KoreanJD/orchard-rover/docs/robot-arm-spec.md

# 로봇팔 사양 (6축) — 검증본

작성: 2026-10-26 · 검증: `arm_check.py`, `arm_workspace.py`, `transport_check.py` · CAD: `shoulder_joint.py`, `wrist_joint.py`, `arm_assembly.py`, `base_joint.py` · 케이블: [robot-arm-cable-routing.md](robot-arm-cable-routing.md)

## 개요
- **6축** (J1 요 Z / J2 어깨 Y / J3 팔꿈치 Y / J4 전완 롤 X / J5 손목 피치 Y / J6 툴 롤 X) — 협동로봇 표준 6R
- 리치 1,050 mm (J2 축 → ISO 플랜지), 가반 3 kg, 팁 속도 0.5 m/s (J2 ≤ 25~30°/s)
- 팔 자중 ≈ 15 kg, 36 V DC, CAN, IP54
- 툴: 집게 / 전동 가위(톱 대체, 모델 선정 보류 — 1순위 마끼다 DUP361 36V 33mm) / 예초기, ISO 9409-1-50-4-M6 + 수동 퀵체인저
- 베이스 마운트: 구동체 상단 레일 X=+300 (차동 바 스윙 영역 X=−150±120 회피), J2 축 Z=958
- 관절 한계: J1 ±180 / J2 −20~90 / **J3 ±120 (케이블 드럼 제약)** / J4 ±180 / J5 ±110 / J6 ±180

## 작업 영역 (툴 팁 = 플랜지 + 150)
| 작업 높이 | 전방 도달 (차체 중심 기준) |
|---|---|
| 최대 높이 2.16 m | X≈0.3 (차체 바로 위) |
| 2.0 m | 0.95 m |
| 1.5 m | 1.38 m |
| 1.0 m | 1.50 m (최대), 측방 1.2 m |
| 0.5 m | 1.42 m |
| 0.1 m (밑동 제초) | ~0.9 m |

**[결정] 작업 범위 = 수관 하단~중단 0~2.0 m. 2 m 이상 상단 전정은 사람 작업으로 분리.**
대안: ① J2 축 +300 상향 → 2.46 m, 전도 마진 1.9→1.6 / ② 링크 +100 연장 → 2.36 m, J2 토크 +20%

## 운반 자세 (`transport_check.py`, 간섭 최소 거리 기준 ≥ 15 mm)
| 자세 | 관절각 (J1/J2/J3/J5) | 최소 거리 | 외형 X | 높이 | 비고 |
|---|---|---|---|---|---|
| **T3 뒤로 접기 (기본)** | 180 / 60 / −120 / 60 | 92.3 (전완↔상완) | −289 ~ +382 (차체 안) | 1.47 m | 차동 바 231, 배터리 존 125 |
| T6 뒤로 저자세 | 180 / 40 / −120 / 80 | 15.7 (플랜지↔배터리 존) | 차체 안 | 1.44 m | 배터리 배치 확정 후 |
| T4 앞으로 접기 | 0 / 45 / −120 / 75 | 72.1 (상완↔가스 스프링 클레비스) | +891 전방 돌출 | 1.39 m | |
| 뒤로 J2 ≤ 25° | 180 / 25~0 | **0 (충돌)** | — | — | 차동 포스트·프레임 |

## 링크
베이스→어깨 200 / 상완 500 (HFS6-3030 ×2 사다리, Z 60 간격 — 케이블 채널 겸용, 양단 링 하우징 회피로 X 85~415) / 전완 422 (J4 하우징 80 + Al 튜브 Ø50×2t) / 손목 128
J2·J3 모두 출력 플랜지가 상완 측판 +Y 면에 체결, 모터는 +Y. J2 고정부(링·모터)는 J1 브라켓, J3 고정부는 전완판(J3 어댑터 겸용 10t)에 체결 → J4 하우징은 YZ 연결 브라켓(J4 모터 통과 창)에 체결, J3 축 +120 (J4 모터가 J3 링 하우징 뒤로 빠지지 않도록). 손목 체인은 팔 중심선(Y=0)

## 관절 액추에이터 (스테퍼 실사용 = 홀딩 50%, η 0.8, 동적 계수 1.5)
| 관절 | 축 | 정적 토크 | 필요 | 액추에이터 | 출력 | 속도 |
|---|---|---|---|---|---|---|
| J1 요 | Z | — | 15 | NEMA23 2.0 + 1:15 유성, 크로스롤러 80/120/16 | 24 | 45°/s |
| J2 어깨 | Y | 79.7 | 65 (가스 스프링 FGSS22120C 필수, 전 각도 최대) | NEMA23 4.0 (57×112) + 1:50 사이클로이드 + 브레이크 | 80 | 30°/s |
| J3 팔꿈치 | Y | 30.1 | 45 | NEMA23 3.0 (57×76) + 1:45 사이클로이드 + 브레이크 | 54 | 30°/s |
| J4 전완 롤 | X | 6.5 | 9.7 | NEMA17 0.8 + 1:36 유성 | 11.5 | 45°/s |
| J5 손목 피치 | Y | 5.5 | 8.2 | NEMA17 0.8 + 1:36 유성 | 11.5 | 45°/s |
| J6 툴 롤 | X | 0.9 | 1.5 | NEMA17 0.45 + 1:20 유성 | 3.6 | 60°/s |

주의: 사이클로이드/하모닉은 역구동됨 → J2·J3 전자 브레이크 필수

## 사이클로이드 감속기 (자체 제작)
| | J2 (50:1) | J3 (45:1) |
|---|---|---|
| 핀 | 51 × Ø5 다월핀, R=70 | 46 × Ø5, R=63 |
| 편심 e | 0.6 | 0.6 |
| 디스크 | OD 136, Al 8t ×2 (180°) | OD 122, 8t ×2 |
| 출력 핀 | Ø8 ×8 @PCD 80 | Ø8 ×8 @PCD 72 |
| 하우징 OD | 165 | 151 |
- 설계 규칙: `e < R/N` 만으로 부족 — **핀 간격(2πR/N − 2Rr) ≥ Rr** 이 지배적
- 프로파일: 기준 에피트로코이드를 Rr 만큼 법선 오프셋(수치), DXF 출력

## 손목
J4 하우징 Ø76×80 → 전완 튜브 Ø50×2t → J5 요크(뒷판 + 12t 양측, 길이 85) → 손목 블록 50×60×60 (J6, 카메라 마운트) → ISO 9409-1-50 플랜지 Ø63×8
- J4 하우징 보어: 모터 여유 Ø58 | 감속기 파일럿 Ø42 | 축 여유 Ø46 | 롤 베어링 6810 시트 Ø65. 출력 허브가 베어링 내륜을 관통, 감속기 출력축 Ø8 보어
- J5: +Y 감속기 출력면 ↔ 블록 Ø12 축, −Y 치크 6001 ↔ 블록 Ø12 축. 요크 뒷판은 J5 ±110° 에서 블록·카메라 회전 반경(≈56) 밖
- 손목 블록: J6 모터 포켓(후면 개방), 앞벽 5t 에 모터 전면·J6 감속기 체결

## 사이클로이드 조인트 적층 (J2·J3 공통)
어댑터 10t(J2 = J1 브라켓, J3 = 전완판) | 링 하우징(핀 구간 20 + 출력 베어링 외륜 시트 W−0.5) | 디스크 8t ×2 (캠 베어링 6002 ×2) | 출력 플랜지 (저널 = 베어링 내경, 캡 하면 릴리프 0.5 로 내륜만 접촉)

## 가동 범위 간섭 (`motion_check.py`, 부품 단위 간섭 > 1 mm³)
J1 ±180 / J2 −20~90 / J3 ±120 / J4 ±180 / J5 ±110 / J6 ±180 단일 관절 스윕(10°, 171 자세) 충돌 없음.
조합 210 자세 중 28 충돌 — **모두 팔 ↔ 차체** (팔 자체 간섭 없음), 경로 계획에서 회피할 운용 제약:
- J2 = −20 에서 |J1| ≥ 135 (뒤쪽): 전완판·J4 하우징 ↔ 차동 포스트·바, J3 = −120 이면 J3 모터 ↔ 로커 플레이트
- J1 = ±90 (측면) 에서 J2 ≤ 0, J3 = −120: J4 하우징·전완 튜브 ↔ 프레임 상단 레일
- J2 = 0, J3 = −120 (전완을 아래로 접음): J5 모터(J4 = −90) 또는 ISO 플랜지(J5 ≈ ±90~110) ↔ 프레임
세부 목록은 `output/arm/motion_check.txt`

## 가스 스프링 밸런서 (J2)
**[결정 2026-10-31] MISUMI FGSS22120C** (가스스프링 장착방향자유형: 스트로크 120, 아이 간 320~440, 반력 392 N @최대−10, 실린더 Ø22). 압축형, 상완 측판 바깥 평면 (팔 좌표 Y −76).
- 베이스 앵커: 팔 좌표 (−35, −150) = J1 터릿 상면 위 50 클레비스 (J1 축에서 X −35)
- 상완 앵커: J2 축에서 r 280, 팔 방향보다 +10° (측판 X 276 / Z 49) — J2 측판을 X 210 → 285 로 연장 (J3 측판 X 290 과 5 간격), M8 스터드
- J2 −20~90° 길이 327~434 (양끝 여유 7 / 6), 수평 보상 48.6 N·m (61 %)
- J2 액추에이터 부담 (전개+툴 79.7 cosφ / 접힘·툴 없음 23.2 cosφ 중 큰 쪽 ×1.5): 최대 **65.3 N·m @31°** (용량 80 의 82 %). 스프링 없으면 120 N·m
- 가스 스프링 반력은 거의 일정이라 cosφ 형 중력을 정확히 따라가지 못함 → 부담은 각도 전 구간에서 계산 (`gas_spring_balance`). 반력 증가율 +30 % (압축 끝) 는 카탈로그 미기재라 일반값 가정
- 선정 과정: FGSS 17 종 × 앵커 위치 탐색. 이전 기하 (r 100, h 180, 350 N) 는 길이 174~279 (신축비 1.6) 가 필요해 맞는 표준품이 없었음. 스프링 없이 NEMA34 (160 N·m) 로 가는 안은 감속기 재검토 부담으로 보류

## J1 베이스
베이스 플레이트 12t (200×820) → 크로스롤러 → 터릿 12t → 수직 브라켓 10t (폭 180, 상단 R90, 수직 거셋 12t ×2: 깊이 60 × 높이 240) → J2. 브라켓이 J2 사이클로이드 어댑터를 겸함 (+Y 면 NEMA23, −Y 면 링 하우징). 구동부는 플레이트 아래 매달림

## 부품 강도 (`arm_check.plate_strength`, 수평 완전 전개·툴 3 kg·동적 ×1.5, 항복 기준)
| 부품 | 응력 | 안전율 | 비고 |
|---|---|---|---|
| J1 브라켓 10t + 거셋 | 4.0 MPa | 70 | J2 토크 80 N·m(액추에이터 최대) + 축 하중(스프링 반력 포함). 면외 휨에 의한 팔 끝 변위 0.04 mm (팔 자체 처짐 0.62 mm 의 6%) |
| 전완판 10t (J4 모터 창 단면) | 3.2 MPa | 85 | |
| J4 하우징 베어링 시트 (벽 5.5) | 1.5 MPa | 186 | 굽힘 + J4 출력 토크 비틀림 |
| J5 축 Ø12 (SUS304) | 1.3 MPa | 158 | |
- 거셋이 수평 삼각으로 잘못 모델링돼 면외 강성이 없었음 → 수직으로 수정. 수정 전 10t 판 단독이면 팔 끝 변위 0.90 mm
- 팔 처짐 계산의 전완 단면을 실제 형상(Al 튜브 Ø50×2t, I 8.7×10⁴)으로 수정 (이전엔 HFS 3030 단면) → 팔 끝 처짐 1.14 → 0.62 mm

## 가공 도면 (`plate_dxf.py` → `output/dxf/`, 두께 중앙 단면, 구멍 위치 = 조립 좌표)
상완 측판 J2·J3, 전완판, 연결 브라켓, J1 브라켓·거셋, J1 베이스 플레이트·터릿. 목록·두께·구멍 수: `output/dxf/plates.txt`

## 전도 (구동체 60 kg + 팔 15 + 툴 3, 트랙 반폭 529)
평지 측면 완전 전개 마진 ≈ 4.5 / 횡경사 15° ≈ 2.0 → 경사 10° 이상 측면 리치 70% 제한

## 대표 궤적 (`arm_workspace.py`)
운반(T3) → 상단 전정 (0.90, 1.95) 툴 45° 상향 → 중단 전정 (1.25, 1.30) → 밑동 제초 (0.90, 0.10) 툴 80° 하향 → 운반

## MoveIt2 기술 패키지 (`urdf_export.py` → `output/urdf/orchard_rover_description/`)
- ROS 2 ament 패키지: `urdf/orchard_rover.urdf`, `srdf/orchard_rover.srdf`, `meshes/{visual,collision}/*.stl` (mm STL × 0.001)
- 링크: base_link(구동체 + J1 고정부) → j1_link → upper_arm → forearm_root → forearm_tube → wrist → flange → tool0
- 관절 축·부호는 CAD 자세 함수(`place`)와 동일: J1 +Z, J2·J3·J5 −Y (양수 = 들어 올림), J4·J6 +X. 원점 J2 축 = (0.300, 0, 0.958) m
- 한계 = 가동 범위 표, effort·velocity = 액추에이터 표. SRDF: arm 그룹(base_link→tool0), home·transport(T3) 자세, 인접 링크 충돌 제외
- 충돌 메시는 coarse (공차 3 mm). 관성은 CAD 체적 × Al 밀도 근사 (모터 실밀도 아님) — 동역학 제어용으로는 실측 보정 필요
- 가스 스프링은 2체 부품이라 미포함. 조합 자세의 팔↔차체 충돌 구간(가동 범위 절)은 base_link 충돌 메시로 MoveIt 이 회피
- 검증: URDF 순기구학으로 옮긴 부품 질량중심 = CAD 자세 (임의 6축 자세 3종, 0.01 mm 이내)

## 제어
SBC + ROS2·MoveIt2 → CAN 마스터 MCU 100 Hz → CAN 폐루프 스테퍼 드라이버 ×6 (모터 일체). 손목 카메라 비전 서보, 툴 접촉 센서, 전류 한계 충돌 감지

## 비용 ≈ 255만원 (팔) + 툴 3종·체인저·카메라 ≈ 90만

## 점검 이력 (2026-10-26)
- 스테퍼 홀딩 토크 오류 교정 → J2/J3/J4 상향 / 역구동 오류 교정 → 브레이크 / 경사 전도 CG 항 추가
- 사이클로이드 핀 겹침 교정 (R 52→70, 핀 Ø8→Ø5) / 5축→6축 / J3 1:40→1:45
- 작업 범위 0~2.0 m 확정 / 케이블 드럼 도입, J3 ±140→±120 / 운반 자세 T3 확정

## 점검 이력 (2026-10-29, Fusion 간섭 검사 후속)
- J3 체결을 J2 와 같은 방향으로 (플랜지→상완 측판, 링·모터→전완판). 기존 배치는 링 Ø151 이 측판 홀 Ø74 를 지나야 해 성립 불가
- 상완 레일 X 60~440 → 85~415 (J2·J3 링 하우징 간섭)
- J1 브라켓 12t(모터 측) → 10t 어댑터 자리 (J2 모터와 겹침)
- 가스 스프링 앵커 축 위 → 축 아래 (계산식과 CAD 부호 불일치), 앵커 포스트 삭제
- (2026-10-31) 가스 스프링을 MISUMI 표준품 FGSS22120C 로 확정, 앵커 재배치, J2 측판 X 285 까지 연장
- 출력 플랜지 볼트 PCD 를 관절별로 (J3 90→76, 캡 Ø96 밖으로 빠지던 문제), 볼트 홀은 캡 두께만
- 링 하우징이 어댑터와 1 mm 떠 있고 출력 베어링 외륜 지지가 없던 문제 → 하우징을 어댑터 면부터 베어링 시트까지 연장, 캠 베어링 추가
- 손목 하우징·블록 솔리드 → 보어·포켓 (J4 하우징 Ø64→76: 베어링 Ø65 가 들어가지 않았음), J5 축 추가
- 가동 범위 검토 신설 → J5 ±110° 에서 블록·카메라가 요크 뒷판과 충돌 → 요크 60→85 (J5 축 위치 불변, 튜브 25 단축)
- 부품 강도 검토 신설 → J1 브라켓 거셋 수평 모델링 오류 수정 (수직 60×240), 판재 DXF 추가
