KoreanJD/orchard-rover/docs/rocker-bogie-suspension.md

# Rocker-Bogie 서스펜션 설계 기록

생성: 2026-10-23 · 도구: CadQuery 2.8 / ezdxf · 코드: `orchard_rover/rocker_bogie_params.py`, `orchard_rover/rocker_bogie_cad.py`
개정: 2026-10-23 — 10인치 휠·전방 허브모터 구동, 피벗 브라켓 SHF16 표준품 치환, BOM 원가 추가
개정: 2026-10-29 — 팔 장착 하중 케이스, 로커 축 Ø20/SHF20/6004ZZ, 전방 외측 포크, 암 폭 70
개정: 2026-10-30 — MISUMI 웹 교차검증: SHF20 T20 반영, 세트 칼라 PSCS20-12, 시리즈 5 홈 위치·M5 체결, 하단 레일 Z 310
개정: 2026-10-31 — 아이들러 축 SFJ20 + SHF20 홀더 + PSCS20-12, 판 일체 베어링 보스 → MISUMI BGRBB 베어링 홀더 볼트 체결, 보기 축 바깥 끝 PSCS12-10, 차동 핀 STWN12 스냅링

## 구조 (NASA MER/MSL 방식)
- 차체 연결점 3개: 좌/우 로커 피벗(측면 레일, 하중 지지) + 차동 바 피벗(상부 중앙, Z축 회전)
- 로커: 전방 휠(F, 구동) + 보기 피벗(B) + 상방 암(U, 차동 링크 연결)
- 보기: 중간 휠(M) + 후방 휠(R) — V자 플레이트, 아이들러
- 차동: 바(878mm, Z축 회전) 양단 ↔ 로커 상방 암을 X 방향 링크 로드(150mm, 로드엔드)로 연결
- 차체 피치 = (좌 로커각 + 우 로커각)/2 (수평 "유지"가 아님)

## 좌표 (X 전방, Y 좌측, Z 상방, 지면 Z=0, 단위 mm)
| 점 | X | Y(좌) | Z |
|---|---|---|---|
| P 로커 피벗 | 0 | 439 | 300 |
| F 전방 휠(구동) | 450 | 529 | 125 |
| M 중간 휠 | 0 | 529 | 125 |
| R 후방 휠 | -450 | 529 | 125 |
| B 보기 피벗 | -225 | 459 | 200 |
| U 상방 암 끝 | 0 | 439 | 750 |
| D 차동 바 피벗 | -150 | 0 | 750 |

휠베이스 900, 트랙 1058 (외측 포크 포함 전폭 1182), 로커 전방 암 483 / 후방 암 246 / 상방 암 450, 보기 암 237×2
프레임: 하단 레일 중심 Z=310(지상고 290), 상단 레일 Z=700. HFS5-4040 은 한 면에 홈 2줄(면 중심 ±10)이라 하단 레일 아래 홈(Z 300)이 로커 피벗 높이

## 프레임 (MISUMI HFS5-4040, `frame_members`)
- 좌우 레일 1000 ×4 (하단 Z 310 / 상단 Z 700) 이 관통, 앞뒤 가로대 720 ×4·차동 크로스멤버 720 ×1·J1 크로스멤버 720 ×2 는 레일 안쪽 면에 맞대기, 기둥 350 ×4 는 하단 레일 위 / 상단 레일 아래 맞대기 → 15 본, 10.44 m, 13.4 kg (카탈로그 1.28 kg/m)
- 체결: 맞대기 끝단 M5 탭 (코너 구멍 Ø4.2) + 관통 부재 렌치 홀 → M5 캡 스크류 22 곳. 레일 상·측면이 베이스 플레이트·피벗 홀더·차동 포스트 체결면이라 외부 브라켓은 쓰지 않음
- CAD 단면: 외곽·홈 위치(면 중심 ±10)·홈 개구 6·코너 구멍은 카탈로그, T홈 내부·중앙 공동은 근사
- 절단 목록: `output/robot/frame_cut_list.txt`

## 설계 근거
- 로커 피벗 X = (x_F + 2·x_B)/3 → 3륜 등하중 (각 98 N @ 60 kg). 피벗을 뒤로 옮기면 전방 휠이 가벼워져 등반 유리
- 보기 피벗 = 중간·후방 휠 중점, 휠 축보다 75 높음
- 차동 링크는 X 방향 배치 필수 — Y 방향(바 반경 방향)이면 바 끝단 원호 운동으로 구속 과잉
- 차동 1:1 연동 오차 ±15° 범위에서 <0.5°
- 휠 Ø150(UWRF 최대)은 1000mm 프레임·과수원 지면에 과소 → 10인치(Ø250) 공압으로 변경
- 전방 구동 선택: 로커 직결 휠이라 하중이 항상 1/3로 안정. 20cm급 장애물 등반이 필요하면 후방 허브모터 추가(4WD)

## 부품
- 로커/보기/차동 바: Al 6061-T6 12t **단일 두께** 플레이트, 암 폭 70 (워터젯 + 탭, DXF 포함). 베어링 보스를 판과 한 몸으로 깎지 않고
  MISUMI **BGRBB 베어링 홀더 세트**(라운드 플랜지, 베어링 2개·스냅링 조립품, S45C)를 판 구멍(몸통 D, H7)에 끼우고 플랜지를 볼트로 체결:
  | 위치 | 홀더 | 플랜지 Ø×두께 / 몸통 Ø×길이 | 볼트 | 방향 |
  |---|---|---|---|---|
  | 로커 피벗 P | BGRBB6004DD-40 (6004 ×2) | Ø77×11 / Ø50×29 | M6 ×4 @P.C.D.64 (판 탭) | 플랜지 판 안쪽 면, 몸통 바깥으로 17 돌출 |
  | 보기 피벗 B | BGRBB6001DD-25 (6001 ×2) | Ø52×8 / Ø34×17 | M4 ×4 @P.C.D.42 (판 탭) | 플랜지 판 바깥면, 몸통 안쪽으로 5 돌출 |
  | 차동 바 | BGRBB6001DD-25 | 〃 | 〃 (바 중앙 Ø58 패드) | 플랜지 바 윗면, 몸통 아래로 5 돌출 |
  축 위 정지측은 내륜 스페이서로 축방향 위치 결정: SHF20 | 스페이서 Ø28 5.95 | 홀더(회전) | 스페이서 Ø28 4.95 | PSCS20-12,
  로커 판 | 스페이서 Ø16 5.85 | 보기 홀더 | 스페이서 Ø16 3.85 | PSCS12-10, 포스트 기둥 | 스페이서 Ø16 4.85 | 차동 홀더 | 스페이서 Ø16 3.85 | STWN12. 과수원 분진 → 접촉 고무 씰 DD
  (로커 홀더 플랜지 11 만큼 로커가 바깥으로, 보기 홀더 몸통 돌출 때문에 로커-보기 간격 6→8 → 트랙 1032→1058)
- 로커 피벗: SHF20 플랜지형 샤프트 홀더(주조 AC7A, L60·T20(축방향 전체)·t8·A34, 2홀 Ø7 @48 → M5 + 와셔 + HNTT5-5, 하단 레일 아래 홈) + SFJ20 직선축(SUJ2) + BGRBB6004DD-40(로커 판) + PSCS20-12 세트 칼라(외경 40)
- 보기 피벗: SFJ12 길이 53(로커 판 압입) + BGRBB6001DD-25(보기 판) + PSCS12-10 세트 칼라(외경 30, 홀더 플랜지와 간극 1) / 차동 피벗: 포스트 Ø12 핀 + BGRBB6001DD-25(차동 바) + STWN12 축용 C형 스냅링(핀 홈 Ø11.5×1.15, 홀더 윗면 위 1)
- 휠: 전방 10" BLDC 허브모터 36V 350W ×2 (M18 2S 36V 직결), 중간·후방 10" 3.00-4 공압 아이들러 ×4
- 아이들러 축: SFJ20 외팔 축 — 보기 판 구멍 Ø20.05 + 판 바깥면 **SHF20 홀더**(Y축 90° 돌려 볼트 줄 세로, M6 ×2 → 판 12t 탭)로 클램프.
  휠 허브 베어링 내경 20 ×2 (모델 6004ZZ, 시판 3.00-4 휠은 6204 계열 내경 20 이 흔함 → 구매 시 내경 20 선택).
  축 적층: 판 | 홀더 T20 | 스페이서 4 (Ø20/Ø28, 내륜만 받침) | 휠 80 | 와셔 2 | PSCS20-12 칼라 — 축 길이 132.
  SHF20·PSCS20-12 는 로커 피벗과 같은 부품 (아이들러 ×4 에 홀더 4, 칼라 4 추가)
- 전방 허브모터 고정축 M12: 로커 플레이트 + **외측 포크**(12t, 축 → 로커 피벗 방향 185 짧은 암, Ø20 스탠드오프·M10) 양쪽 지지 (`front_fork.dxf`)
- 링크: Ø8 로드 + 로드엔드(PHS8) ×2, 길이 조정식

**[결정 2026-10-29] 로커 축 = Ø20 + 6004ZZ + SHF20/PSCS20-12.** 처음엔 단붙이 Ø16/17/16 을 택했으나, 팔 장착 하중 케이스에서 축 SF 2.49 로 부족해 대안으로 전환:
| 안 | 장점 | 단점 |
|---|---|---|
| 단붙이 Ø16/17/16 | SHF16·6003ZZ 유지 | 축 가공 1품, 팔 하중 SF 2.49 |
| **Ø20 + 6004ZZ + SHF20/PSCS20-12 (채택)** | 전부 표준 직선축, 축 SF 4.86 | 베어링 폭 10→12, 보기-휠 간격 10→16 (축 끝·칼라와 중간 휠 Y 분리) |
| 내경 16 특주 베어링 | 축 그대로 | 조달·단가 불리 |
- MISUMI 교차검증 (2026-10-30): SHF20 의 T20 은 플랜지 포함 축방향 전체 길이 (모델이 28 로 8 길었음 → 돌출 20). `SCS20` 은 미스미에서 섀클(타사) → 세트 칼라는 `PSCS20-12` (외경 40). 시리즈 5 홈 T너트는 M3~M5 뿐이라 SHF20 Ø7 홀도 M5 로 체결

## 하중 케이스 (`load_cases`, `wheel_loads`)
원래 설계는 구동체 60 kg 만이었으나 실제로는 팔 15 kg + 툴 3 kg 이 J1 (X=+300) 에 실린다.
차체 피치 모멘트는 차동 바가 두 로커의 공통 회전을 막으므로 링크를 통해 로커로 들어가 전방 휠 하중을 바꾼다.
| 케이스 | 총 질량 | CG (X, Y) | 전방 휠 (좌/우) | 최저 SF |
|---|---|---|---|---|
| 구동체만 (원설계) | 60 | (0, 0) | 98 / 98 N | 휠 5.10 |
| 운반 (접힘) | 78 | (69, 0) | 167 / 167 | 휠 3.00 |
| 전방 전개 | 78 | (179, 0) | 229 / 229 | 휠 2.18 |
| 대각 45° 전개 | 78 | (147, 78) | 234 / 188 | 휠 2.14 |
| 측방 전개 | 78 | (69, 110) | 199 / 134 | 휠 2.51 |
| 후방 전개 | 78 | (−40, 0) | 105 / 105 | 휠 3.60 |
값은 `output/design_summary.txt` 생성값.

## 안전율 (전 케이스·좌우 최저, 동하중 ×3)
로커 베어링 8.5 / 보기 베어링 6.6 / 휠 2.1 / 로커 면내 굽힘 8.0 / 면외 2.7 / 로커 축@SHF20 4.0 / 전방 허브모터 축 2.6 / 아이들러 축 8.7 / 아이들러 홀더 볼트 22.9
- 기준 2.5. 휠은 정격 1500 N 에 동하중 ×3 을 건 보수적 값이라 2.0 으로 별도 판정 (정적 SF 6.4)
- 이전(구동체만, 외팔보 Ø16 액슬) 기준으로는 전방 액슬 3.8 이었으나, 팔 하중 대각 전개에서 1.6 → 외측 포크로 양쪽 지지
- 아이들러 축: 홀더 보스 끝 단면 외팔보 (휠 중앙 하중, 팔 44), SUS304 σy 205 로 보수적. 홀더 볼트: 판 바깥면 모멘트 ÷ 볼트 간격 48 → M6 8.8 인장
- 보기-휠 간격 16→24 로 전방 허브모터 축 지지 간격이 늘어 2.72→2.62 (기준 2.5 이상)
- 전방 축은 허브모터 M12 고정축(플랫 10 단면, 8.8 급 σy 640 가정) 기준. 축 강종·플랫 치수는 모터 사양으로 확인

## BOM 원가 (추정 ±30%, 서스펜션+전방 구동계만)
| 항목 | 금액(원) |
|---|---|
| 로커·보기 플레이트 워터젯 ×4 | 230,000 |
| SHF20 ×6 + PSCS20-12 ×6 (로커 피벗 2 + 아이들러 4) | 81,000 |
| BGRBB6004DD-40 ×2 (로커) | 87,840 |
| BGRBB6001DD-25 ×3 (보기 2 + 차동 1, DD 는 ZZ ×1.1 추정) | 75,150 |
| PSCS12-10 ×2 (보기 축 바깥 끝) + STWN12 ×1 (차동 핀) | 14,763 |
| 전방 외측 포크 워터젯 ×2 + 스탠드오프 | 40,000 |
| 차동 바·포스트 | 50,000 |
| 허브모터 ×2 + 컨트롤러 ×2 | 300,000 |
| 아이들러 휠 ×4 | 100,000 |
| 축·스페이서·로드엔드·크로스멤버 (피벗 베어링은 홀더 세트에 포함) | 108,000 |
| 체결류 | 30,000 |
| **합계** | **≈ 1,117,000** |

## 미결 사항
- 프레임 상단 중앙 X=−283 ~ −17 (차동 바 피벗 −150 ± 133, ±15° 스윙 + 바 폭) 은 차동 바 스윙 영역 — 배터리 배치 시 비워둘 것. 배터리 팩 규격(M18 2S 형식·치수) 확정 후 배치 모델링
- 허브모터 M12 축 드롭아웃 (플랫 폭·축 길이·토크 와셔) — 모터 사양 확정 후 로커 플레이트·외측 포크 홀을 슬롯으로 교체 (현재 Ø12.05 원형)
- 상세 프레임 브라켓, 블레이드 데크와의 간섭 — 데크 사양 확정 후 검토
- 해결 (2026-10-31): 차동 바 핀 — 홀더 윗면 위 "멈춤링 자리 4" 만 있어 차동 바가 핀에서 위로 빠질 수 있었음 → 위 베어링 내륜 스페이서 Ø16 3.85 + 핀 홈에 STWN12 스냅링 (핀 끝은 홀더 윗면 위 4 그대로 — PSCS12-10 칼라는 핀이 9 길어져 팔을 뒤로 접은 J1 ±180·J3 −120 자세에서 J4 하우징과 닿아 기각)
- 해결 (2026-10-31): 보기 축 바깥 끝 — 로커 판 압입 축에 보기 그룹(홀더·베어링)을 바깥쪽으로 잡아 주는 부품 없이 "멈춤링 자리 10" 만 있었음 → 바깥 베어링 내륜 스페이서 Ø16 3.85 + PSCS12-10 칼라 (축 50→53, 축 끝이 중간 휠 내측면보다 3 안쪽)
- 해결 (2026-10-31): 판 일체 베어링 보스 — 문서는 "12t 워터젯" 인데 모델은 로커 P 보스 30 / 보기 B 보스 20 / 차동 바 허브 20 두께라 2D 가공으로 불가 → MISUMI BGRBB 홀더 볼트 체결, 판은 단일 두께 (로커 축 SF 4.9→4.0, 트랙 1032→1058)
- 해결 (2026-10-31): 아이들러 휠 — 사양 메모의 6003ZZ(내경 17)와 축 Ø16 불일치, 축이 판 구멍에 꽂히기만 하고 고정·빠짐 방지 없음 → SFJ20 + SHF20 홀더 + PSCS20-12 칼라, 보기-휠 간격 16→24 (트랙 1016→1032)
- 해결 (2026-10-29): SHF16 단일 클램프 캔틸레버 → 축 Ø20/SHF20 로 SF 4.9 (2점 지지는 축 굽힘을 줄이지 못해 채택 안 함)
