KoreanJD/orchard-rover/docs/img/cable_routing.png

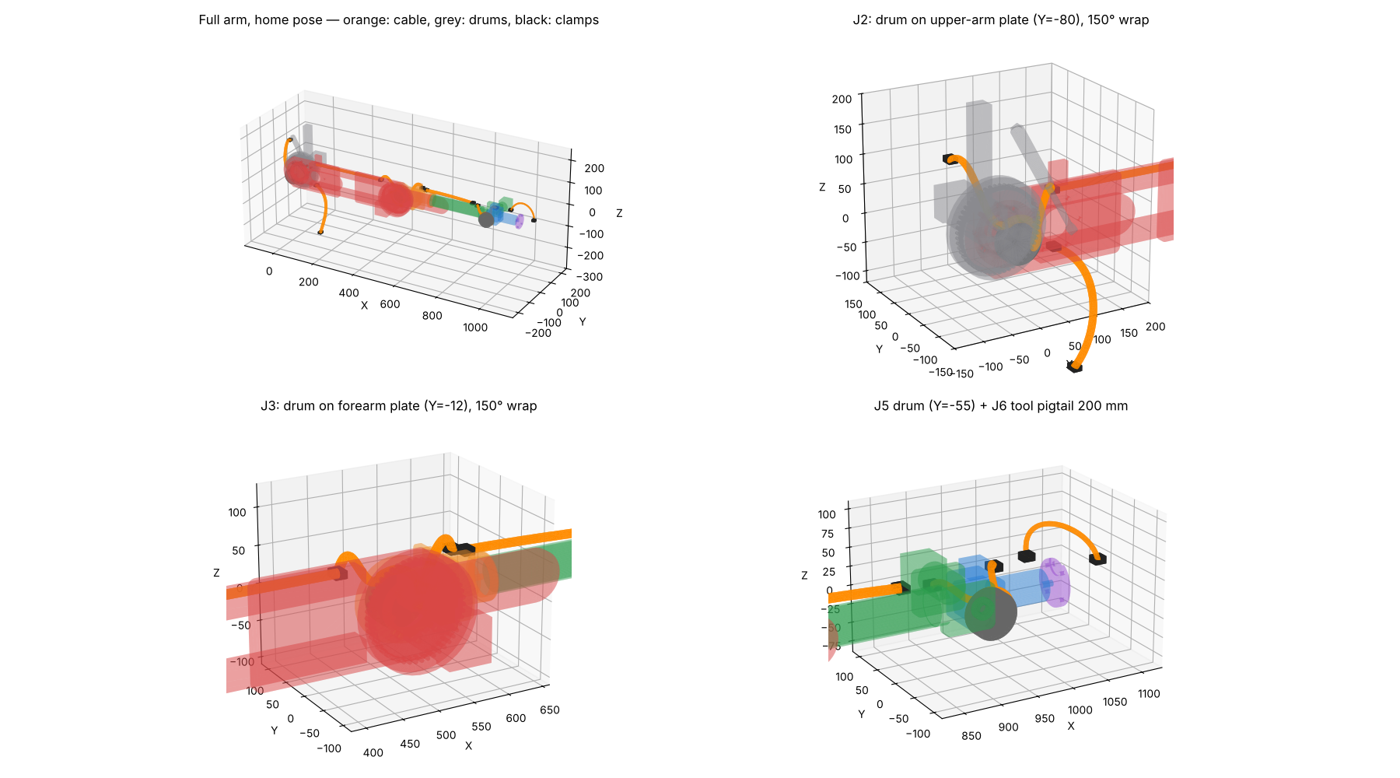
docs/img/cable_routing.png
