KoreanJD/orchard-rover/docs/img/pose_bent.png

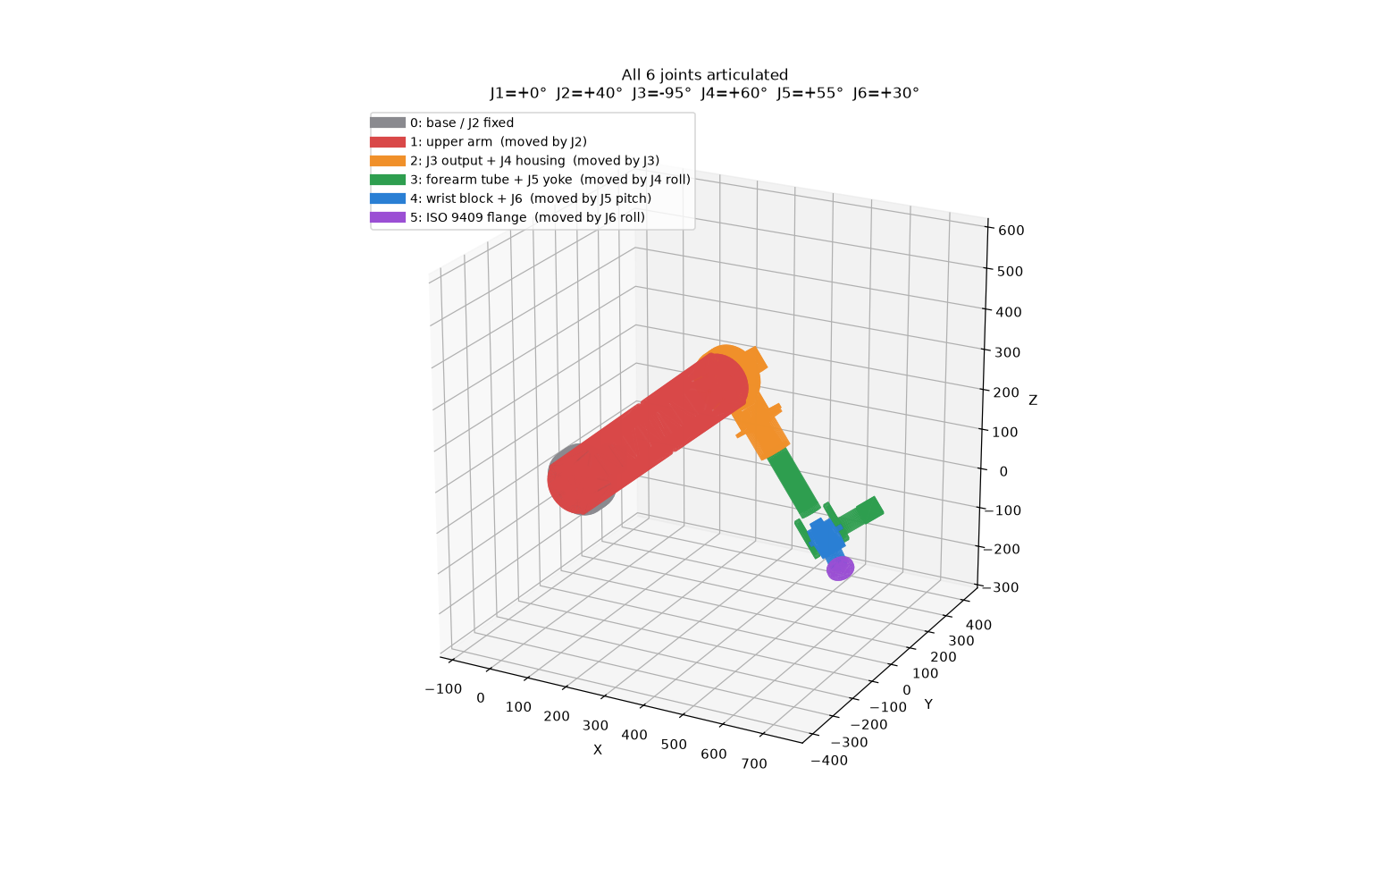
docs/img/pose_bent.png
