KoreanJD/orchard-rover/docs/img/shoulder_cycloid.png

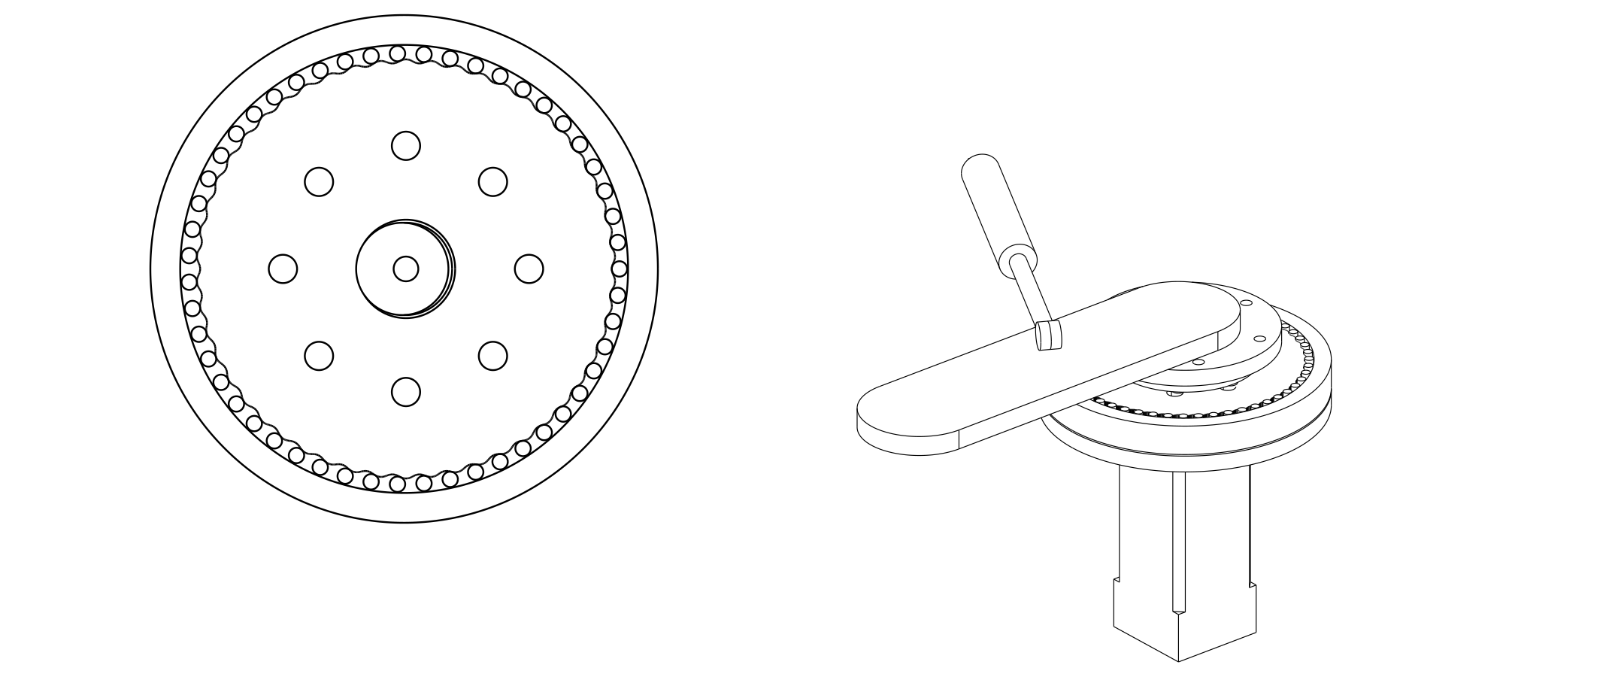
docs/img/shoulder_cycloid.png
