KoreanJD/orchard-rover/docs/img/transport_poses.png

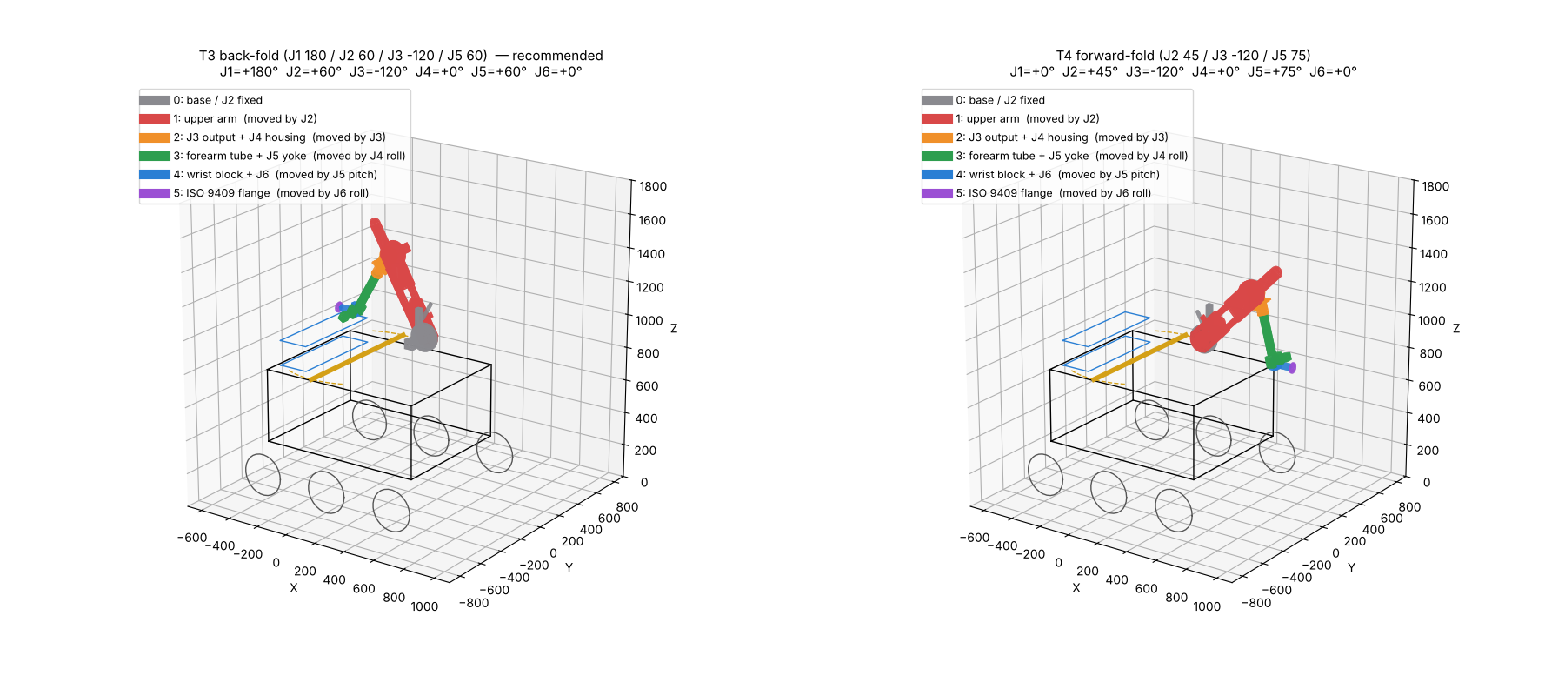
docs/img/transport_poses.png
