KoreanJD/orchard-rover/docs/img/workspace_xz.png

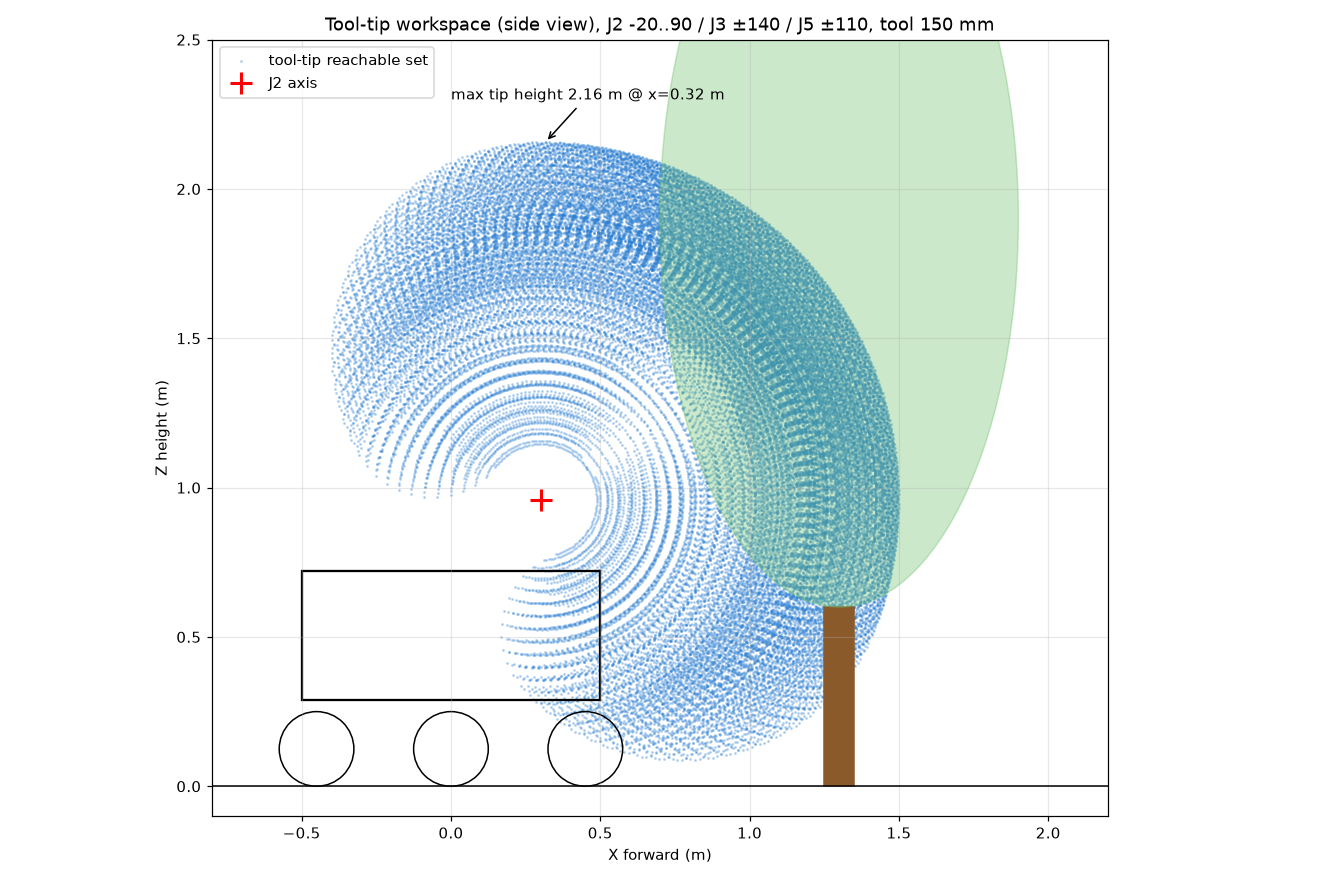
docs/img/workspace_xz.png
