KoreanJD/orchard-rover/output/arm/arm_iso.png

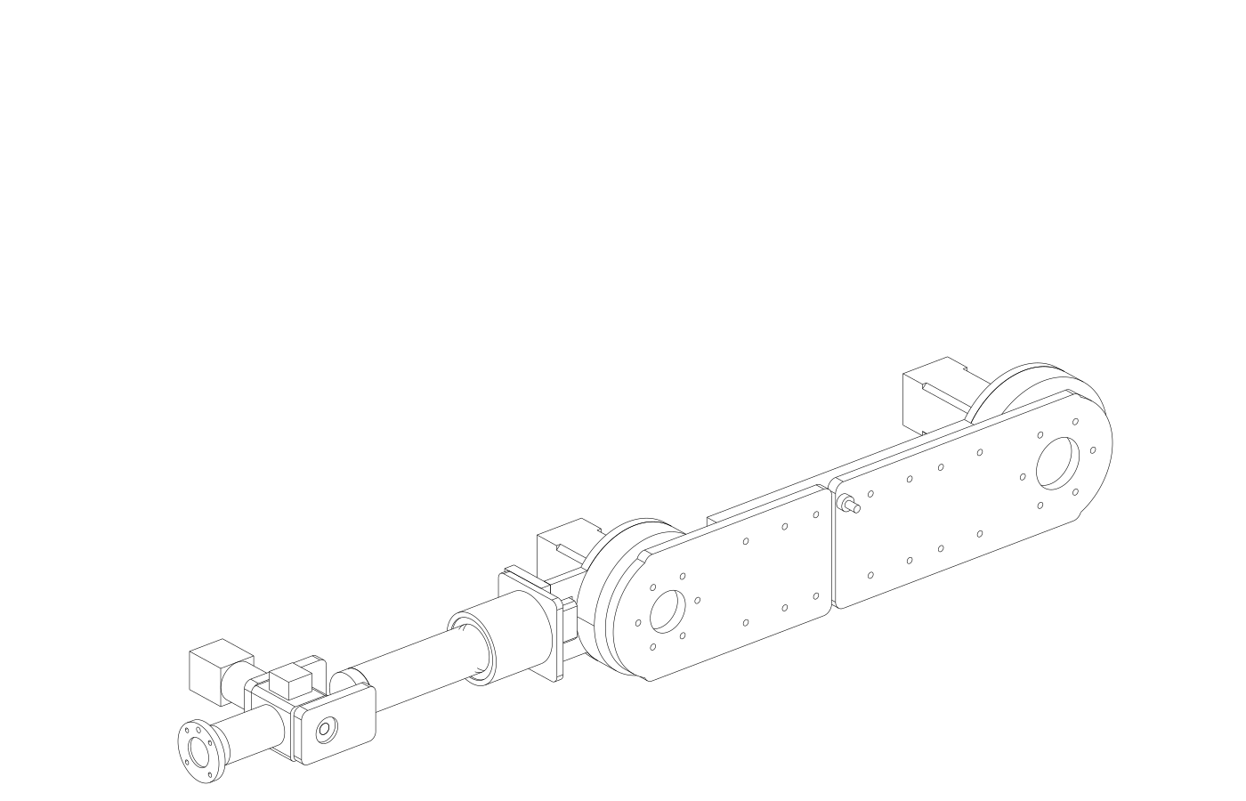
output/arm/arm_iso.png
