KoreanJD/orchard-rover/output/arm/arm_side.png

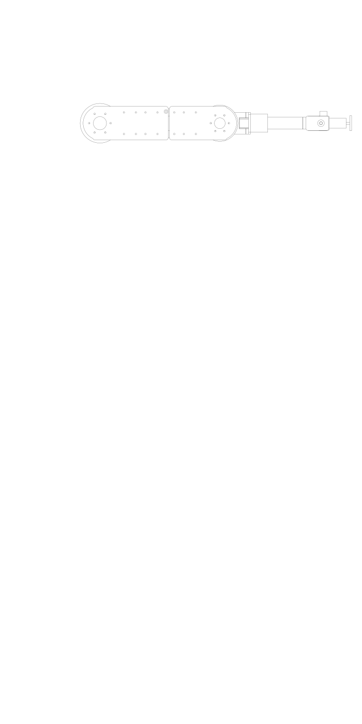
output/arm/arm_side.png
