KoreanJD/orchard-rover/output/arm/pose_fold.png

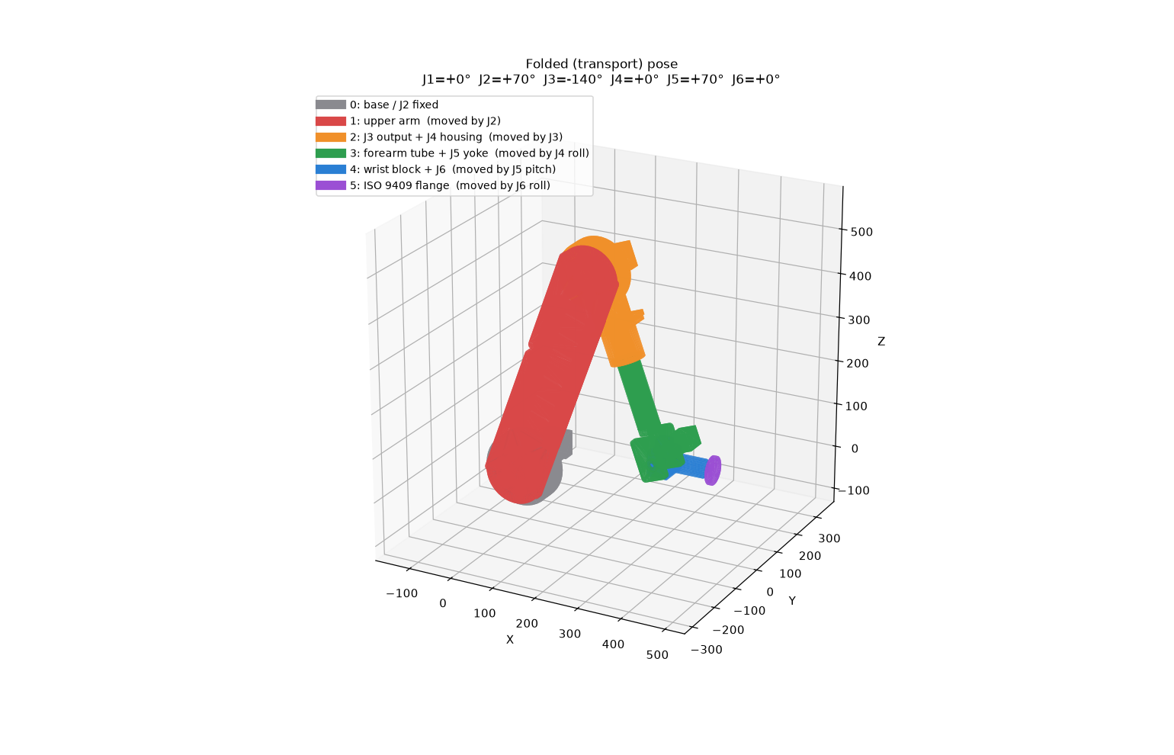
output/arm/pose_fold.png
