KoreanJD/orchard-rover/output/arm/wrist_iso.png

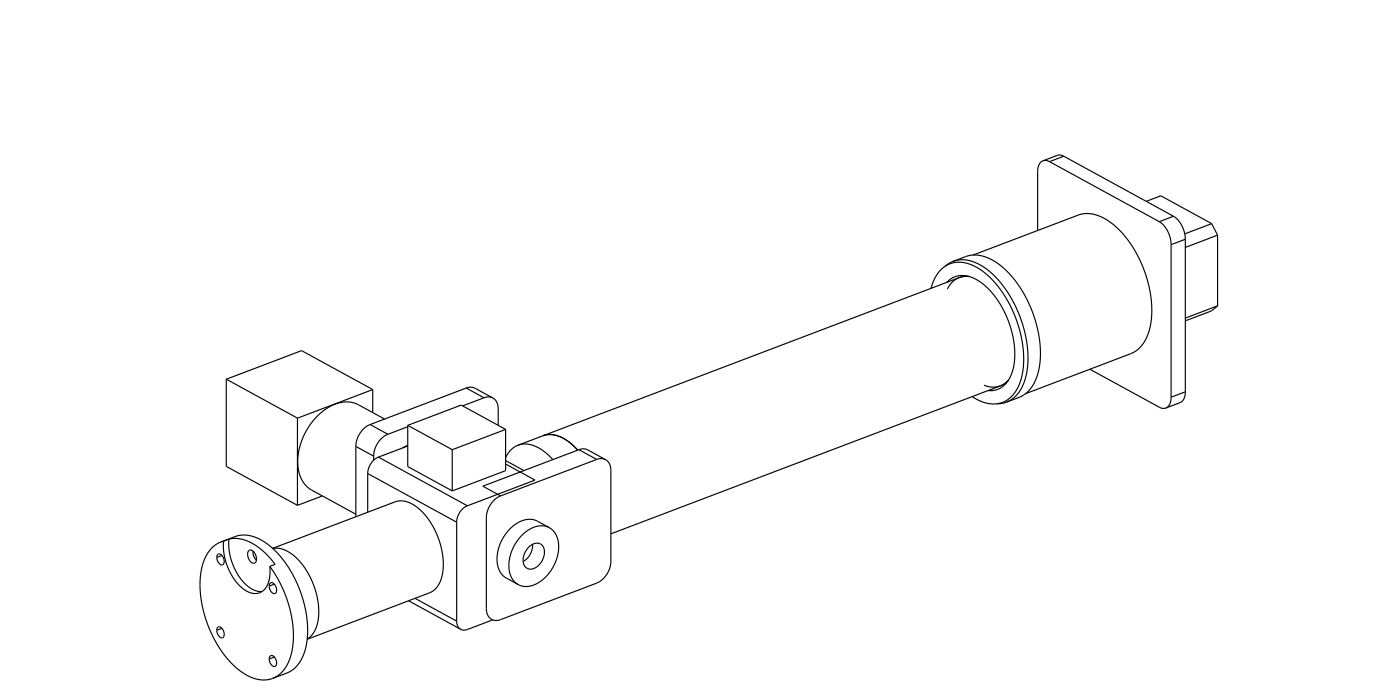
output/arm/wrist_iso.png
