KoreanJD/orchard-rover/output/elbow/shoulder_iso.png

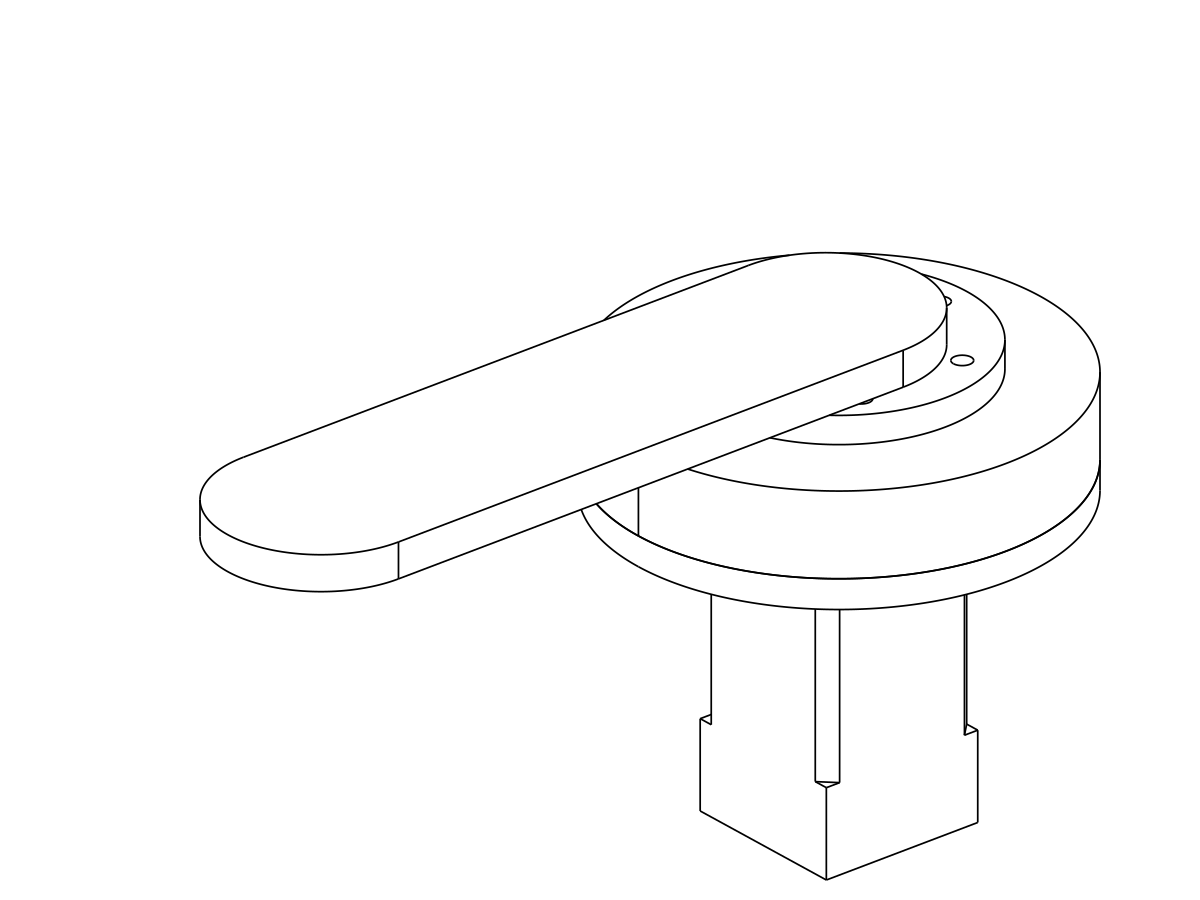
output/elbow/shoulder_iso.png
