KoreanJD/orchard-rover/output/elbow/shoulder_top.png

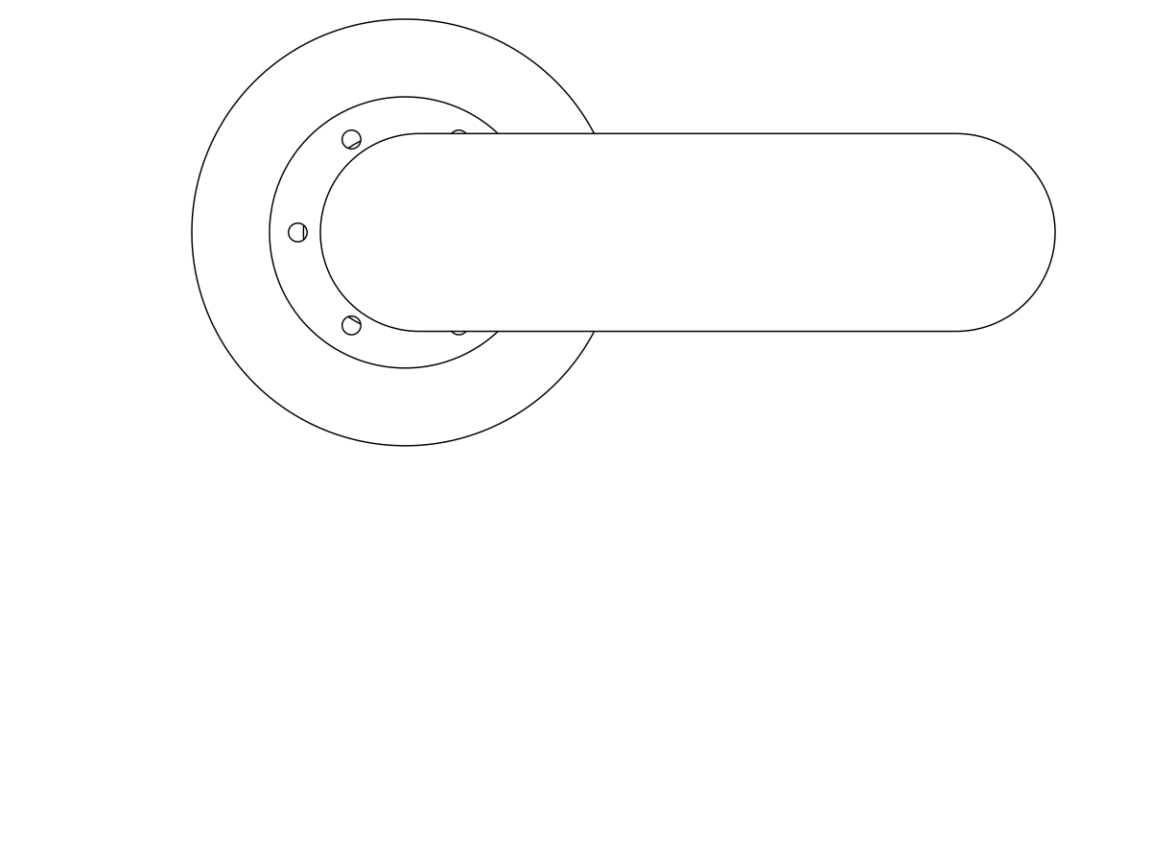
output/elbow/shoulder_top.png
