KoreanJD/orchard-rover/output/robot/robot_front.png

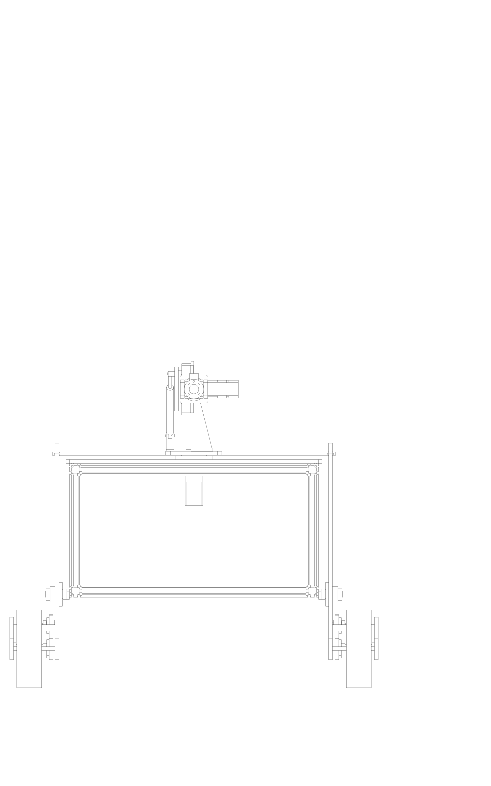
output/robot/robot_front.png
