KoreanJD/orchard-rover/output/robot/robot_side.png

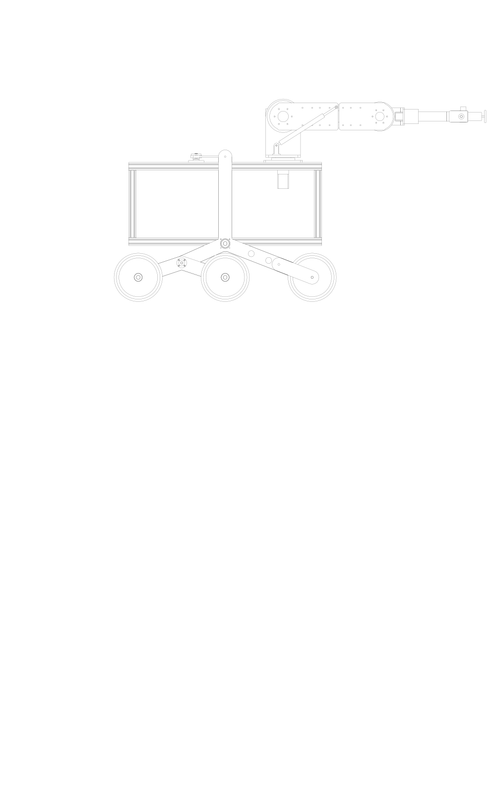
output/robot/robot_side.png
