KoreanJD/orchard-rover/output/rocker_bogie_front.png

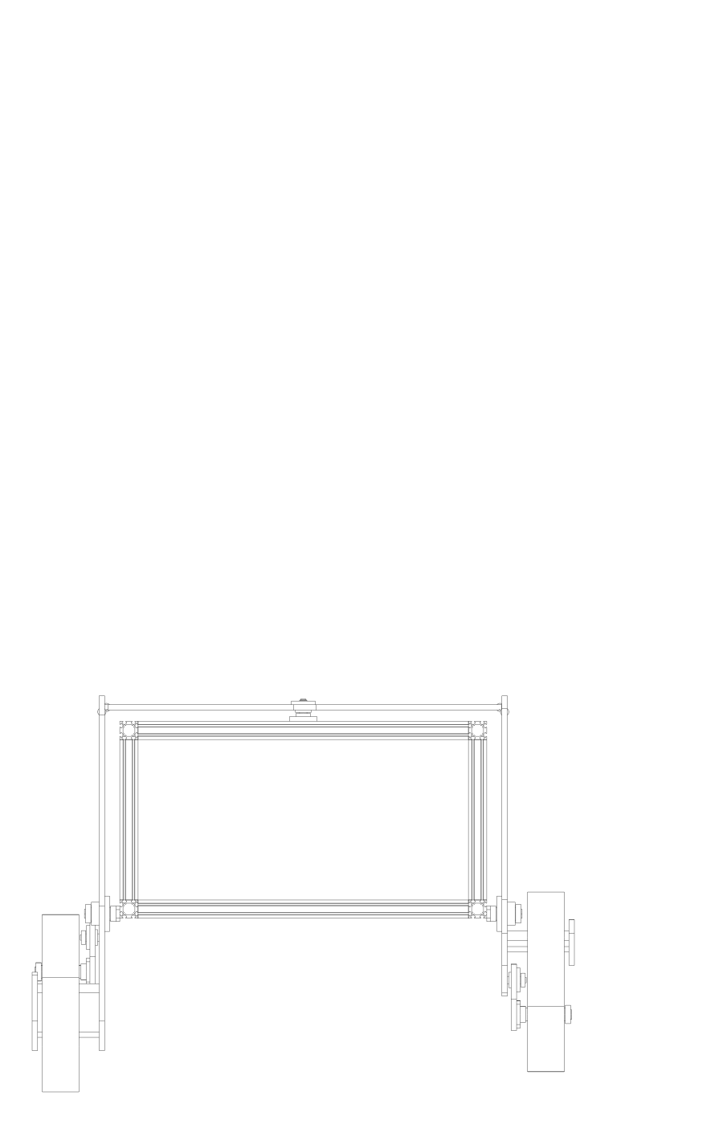
output/rocker_bogie_front.png
