KoreanJD/orchard-rover/output/rocker_bogie_iso.png

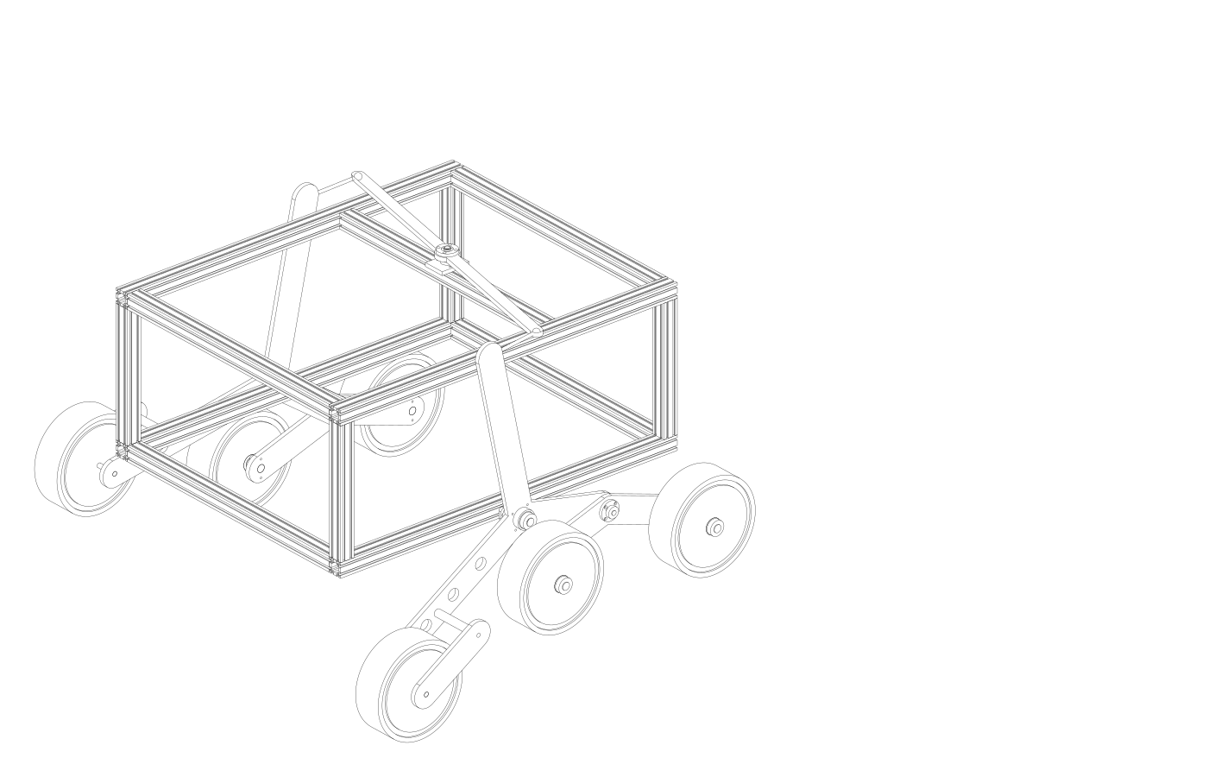
output/rocker_bogie_iso.png
