KoreanJD/orchard-rover/output/rocker_bogie_side.png

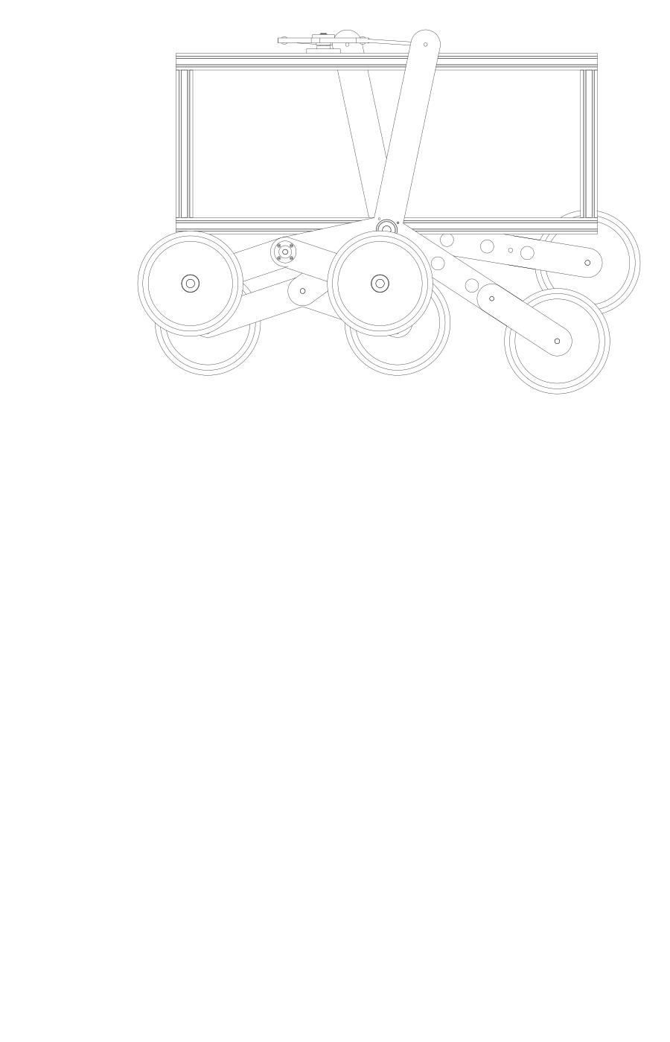
output/rocker_bogie_side.png
