KoreanJD/orchard-rover/output/rocker_bogie_top.png

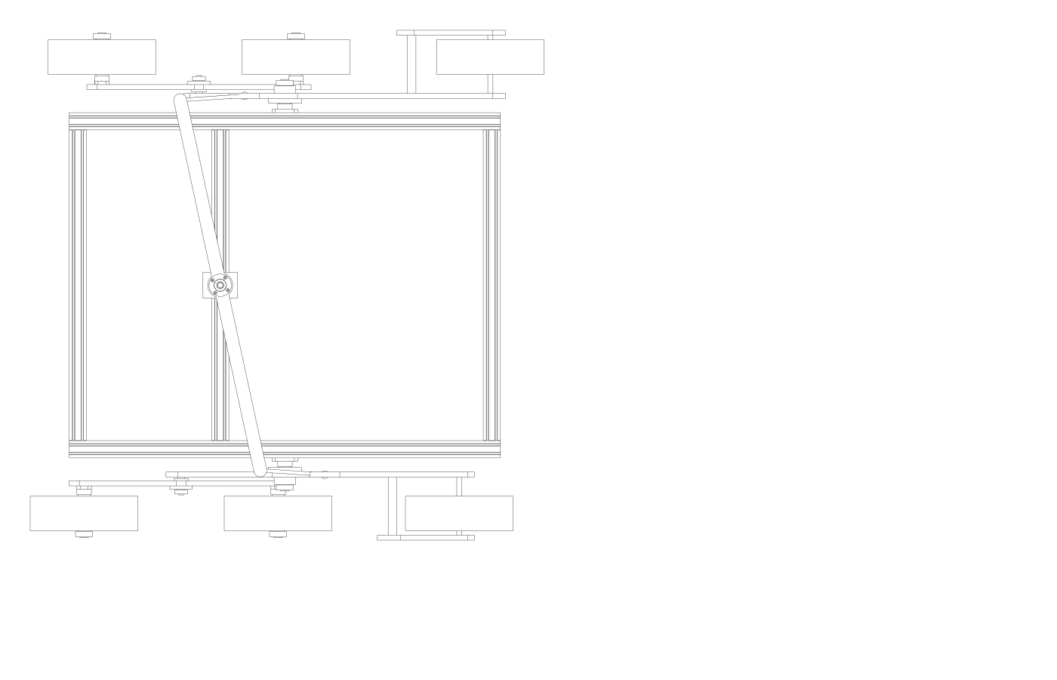
output/rocker_bogie_top.png
