KoreanJD/orchard-rover/output/shoulder/cycloid_internals.png

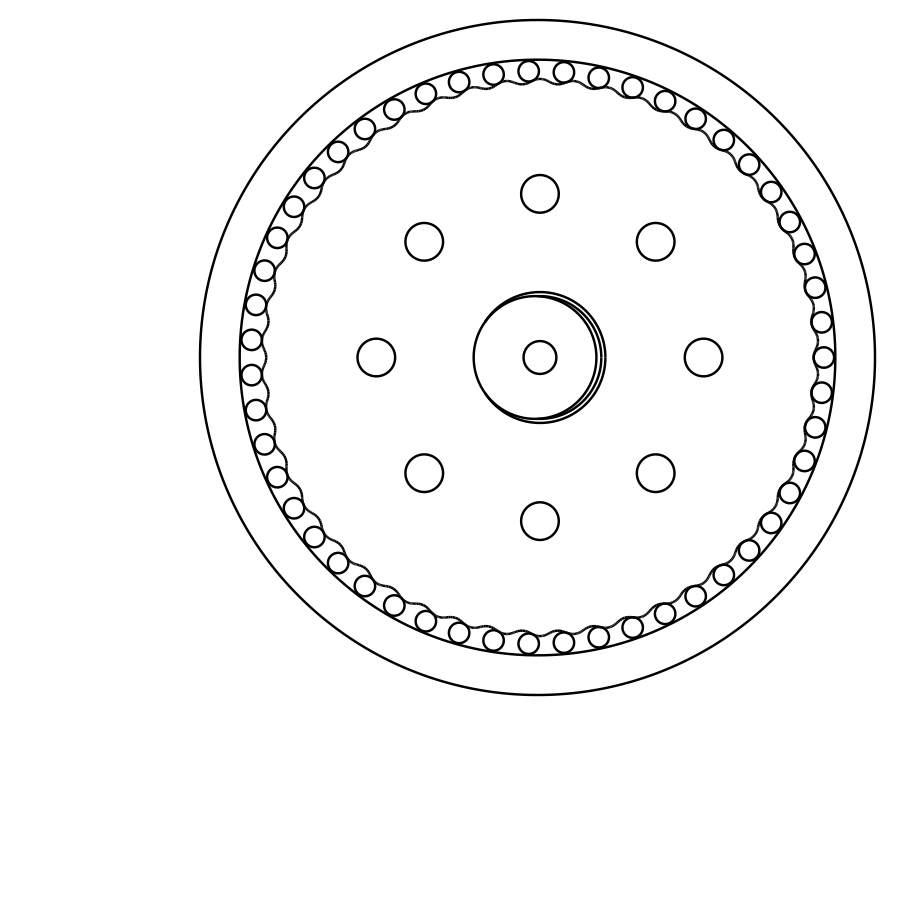
output/shoulder/cycloid_internals.png
