KoreanJD/orchard-rover/output/shoulder/shoulder_iso.png

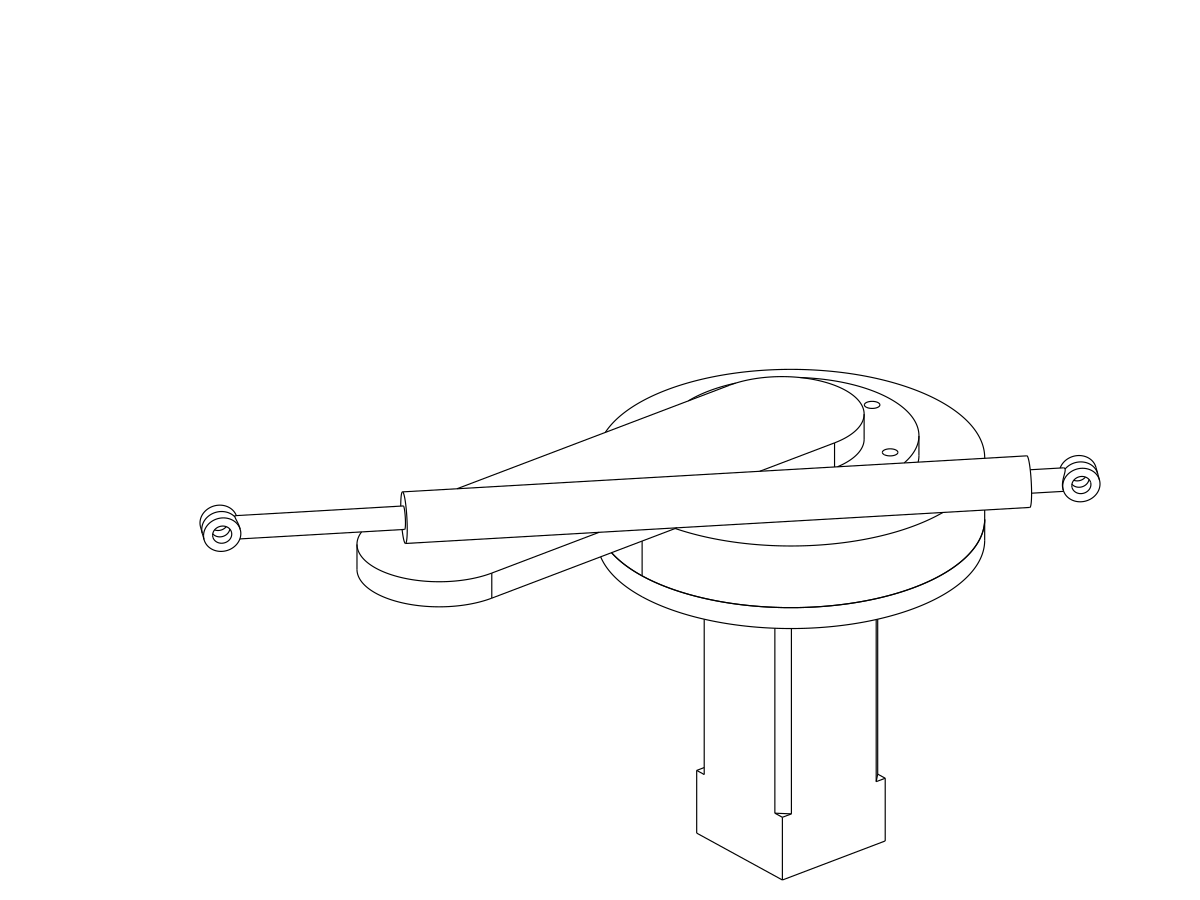
output/shoulder/shoulder_iso.png
