KoreanJD/orchard-rover/output/shoulder/shoulder_top.png

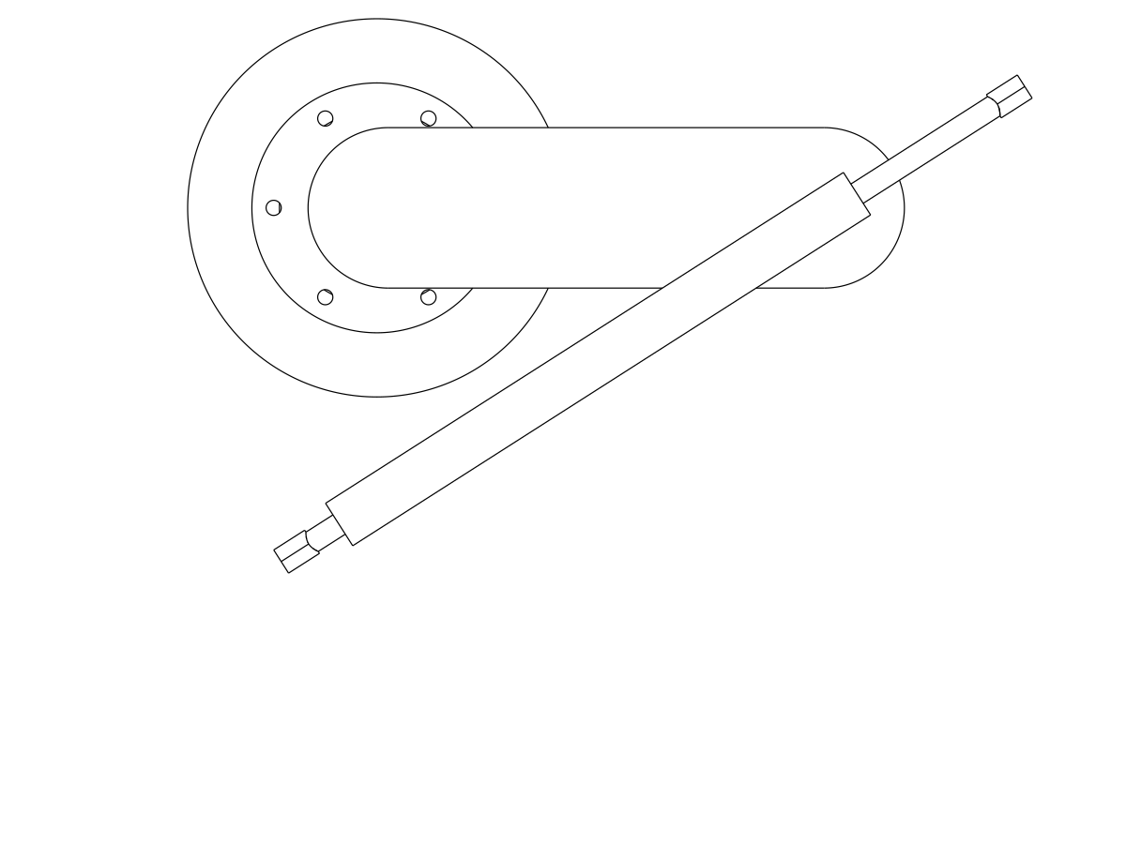
output/shoulder/shoulder_top.png
