KoreanJD/orchard-rover/output/arm/arm_J2_J3_assembly.step

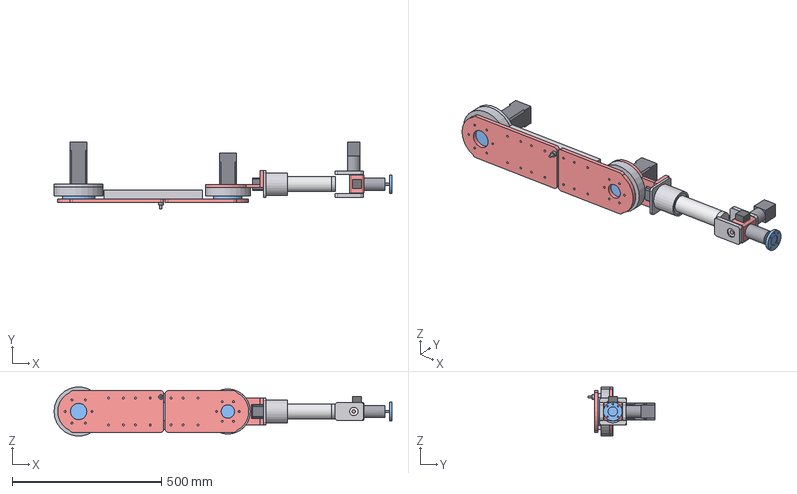
[picture p23: CAD file, 2026-10-31]
output/arm/arm_J2_J3_assembly.step
1132.5 x 226.0 x 163.8 mm
J2_motor
J2_adapter
J2_ring
J2_cam
J2_cam_bearing
J2_disc1
J2_disc2
J2_output_flange
J2_output_bearing
upper_rail_0
upper_rail_1
upper_plate_J2
upper_plate_J3
gs_anchor_arm
J3_motor
J3_ring
J3_cam
J3_cam_bearing
J3_disc1
J3_disc2
J3_output_flange
J3_output_bearing
fore_plate_J3
fore_offset_bracket
j4_housing
j4_motor
j4_gear
forearm_tube
j4_bearing
j5_yoke
j5_motor
j5_gear
j5_bearing
wrist_block
j6_motor
j6_gear
iso_flange
wrist_camera
