KoreanJD/orchard-rover/output/elbow/shoulder_assembly.step

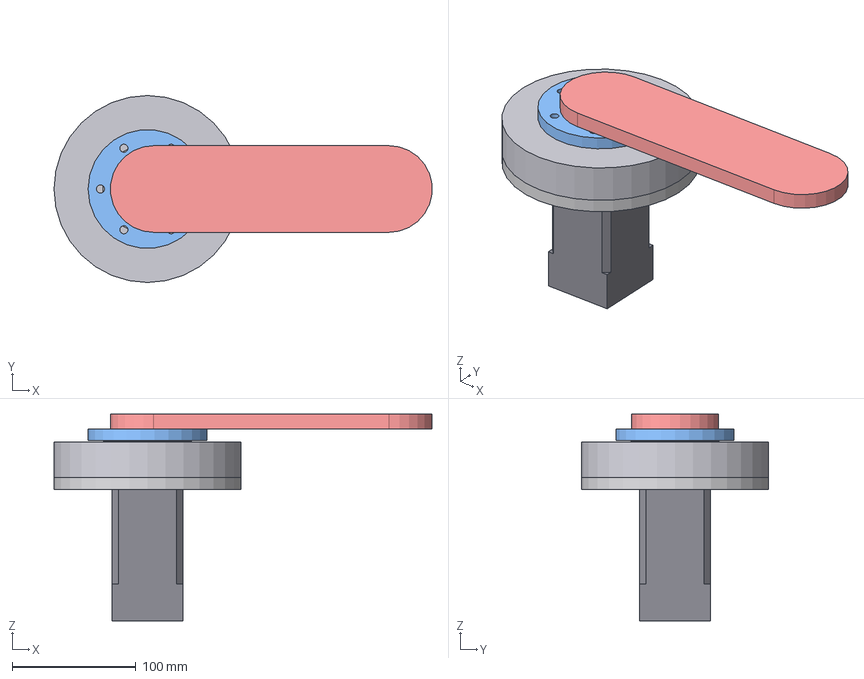
[picture p24: CAD file, 2026-10-31]
output/elbow/shoulder_assembly.step
305.2 x 151.0 x 167.0 mm
motor
adapter
ring
cam
cam_bearing
disc1
disc2
output_flange
output_bearing
upper_arm_plate
