KoreanJD/orchard-rover/output/rocker_bogie_assembly.step

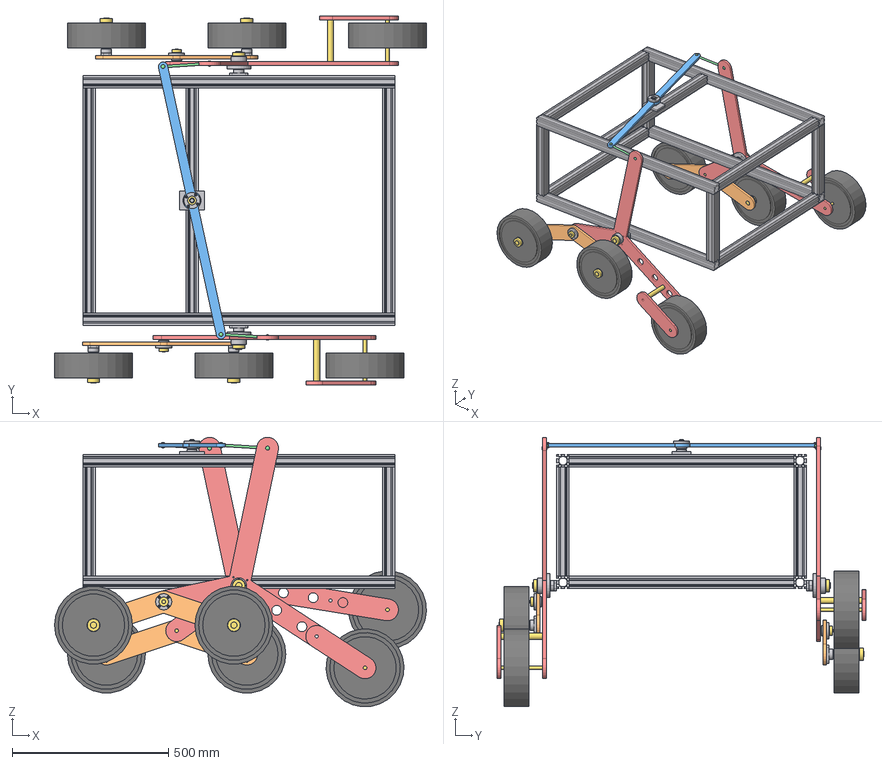
[picture p26: CAD file, 2026-11-05]
output/rocker_bogie_assembly.step
1192.2 x 1182.0 x 863.4 mm
frame_rail_low_L
frame_rail_low_R
frame_cross_low_F
frame_cross_low_B
frame_rail_top_L
frame_rail_top_R
frame_cross_top_F
frame_cross_top_B
frame_post_FL
frame_post_FR
frame_post_BL
frame_post_BR
frame_cross_diff
rocker_plate_L
axle_F_L
wheel_F_L
fork_F_L
standoff_F_L
bogie_shaft_L
rocker_holder_L
bogie_spacer_L
bogie_spacer_out_L
bogie_collar_L
bogie_plate_L
bogie_holder_L
bogie_bearing_L
axle_M_L
axle_holder_M_L
idler_spacer_M_L
wheel_M_L
wheel_bearing_M_L
idler_washer_M_L
idler_collar_M_L
axle_R_L
axle_holder_R_L
idler_spacer_R_L
wheel_R_L
wheel_bearing_R_L
idler_washer_R_L
idler_collar_R_L
pivot_block_L
rocker_shaft_L
rocker_spacer_in_L
rocker_bearing_L
rocker_spacer_out_L
shaft_collar_L
rocker_plate_R
axle_F_R
wheel_F_R
fork_F_R
standoff_F_R
bogie_shaft_R
rocker_holder_R
bogie_spacer_R
bogie_spacer_out_R
bogie_collar_R
bogie_plate_R
bogie_holder_R
bogie_bearing_R
axle_M_R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
