KoreanJD/orchard-rover/output/shoulder/shoulder_assembly.step

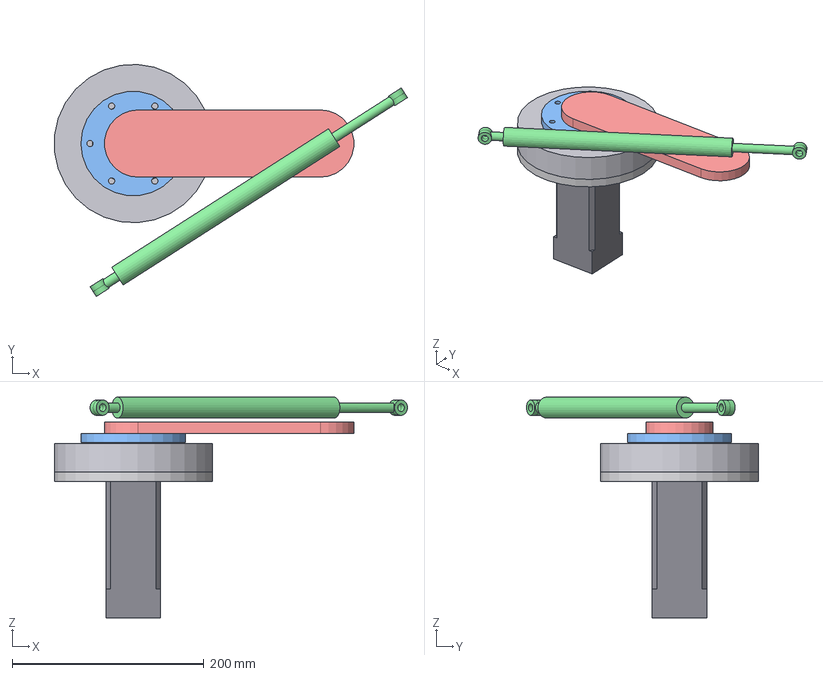
[picture p27: CAD file, 2026-10-31]
output/shoulder/shoulder_assembly.step
367.7 x 241.7 x 229.9 mm
motor
adapter
ring
cam
cam_bearing
disc1
disc2
output_flange
output_bearing
upper_arm_plate
gas_spring
