KoreanJD/orchard-rover/output/dxf/upper_plate_J2.dxf

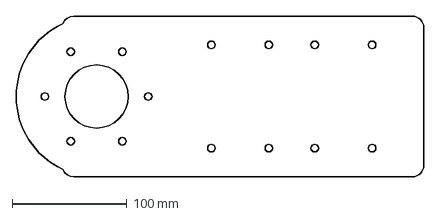
[picture p28: CAD file, 2026-10-31]
output/dxf/upper_plate_J2.dxf
355.0 x 140.0 mm
