KoreanJD/orchard-rover/output/elbow/parts/ring_housing.step

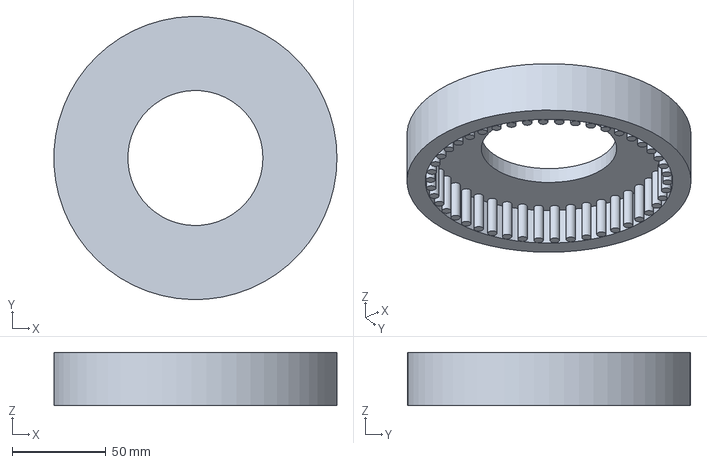
[picture p29: CAD file, 2026-10-31]
output/elbow/parts/ring_housing.step
150.9 x 150.9 x 28.5 mm
