KoreanJD/orchard-rover/output/parts/diff_post.step

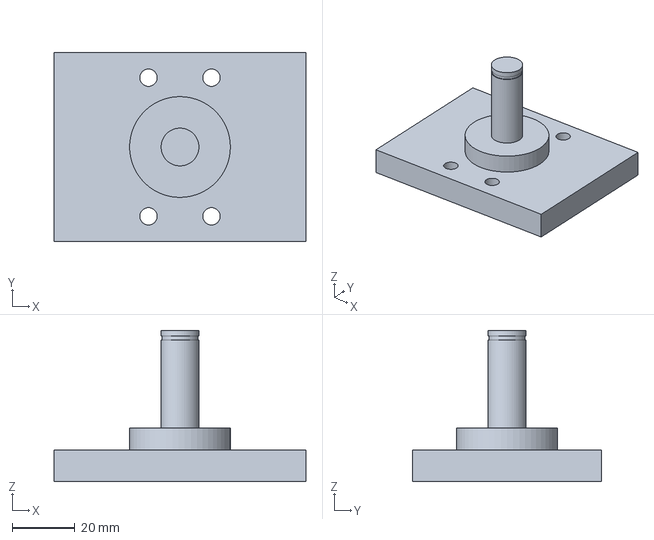
[picture p30: CAD file, 2026-11-05]
output/parts/diff_post.step
80.0 x 60.0 x 48.0 mm
