KoreanJD/orchard-rover/output/shoulder/parts/eccentric_cam.step

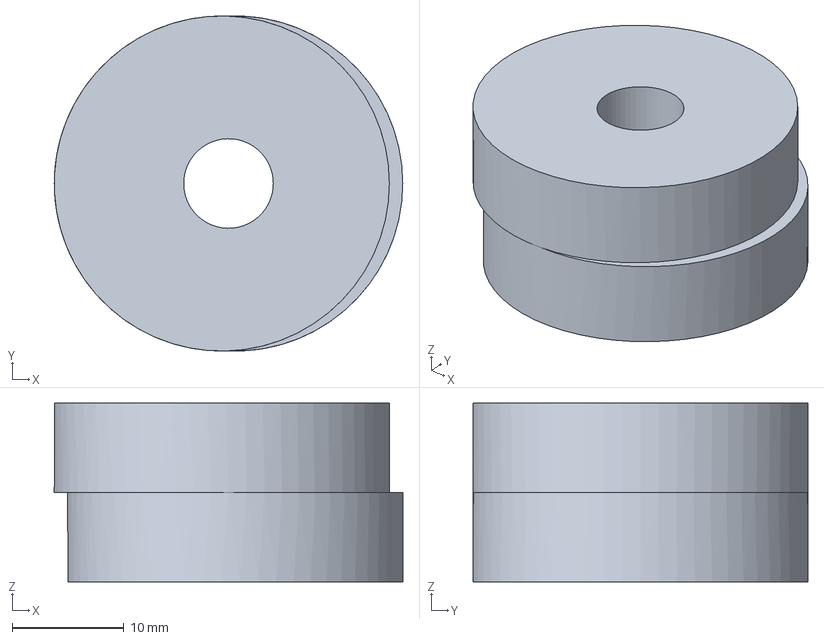
[picture p31: CAD file, 2026-10-31]
output/shoulder/parts/eccentric_cam.step
31.2 x 30.0 x 16.0 mm
