KoreanJD/orchard-rover/output/urdf/orchard_rover_description/meshes/collision/base_link.stl

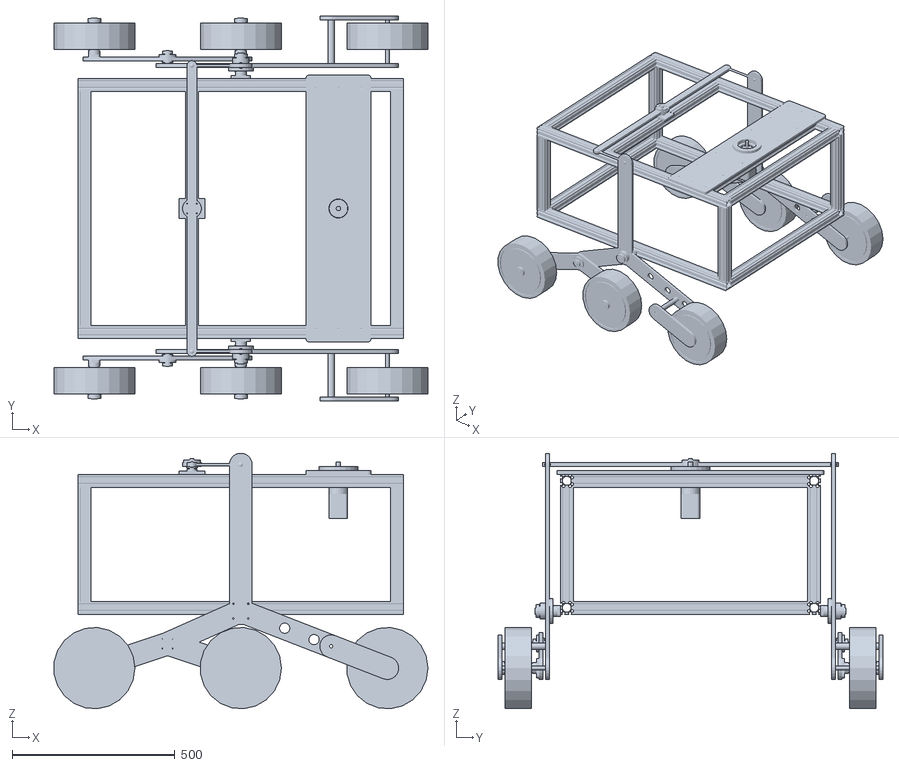
[picture p32: CAD file, 2026-11-05]
output/urdf/orchard_rover_description/meshes/collision/base_link.stl
1148.6 x 1182.0 x 784.3
