KoreanJD/orchard-rover/output/urdf/orchard_rover_description/meshes/visual/base_link.stl

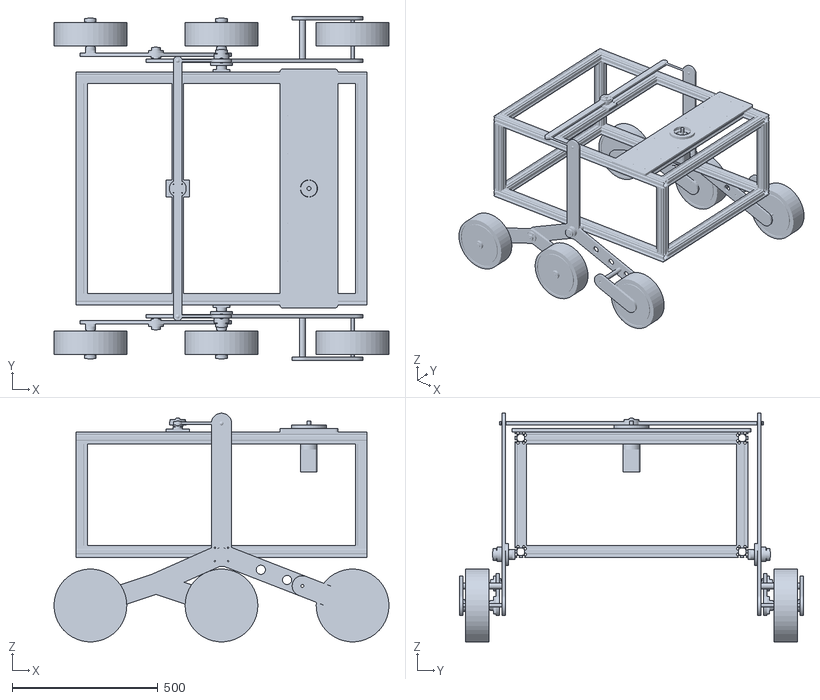
[picture p33: CAD file, 2026-11-05]
output/urdf/orchard_rover_description/meshes/visual/base_link.stl
1150.0 x 1182.0 x 784.6
