KoreanJD/orchard-rover/output/dxf/fore_plate_J3.dxf

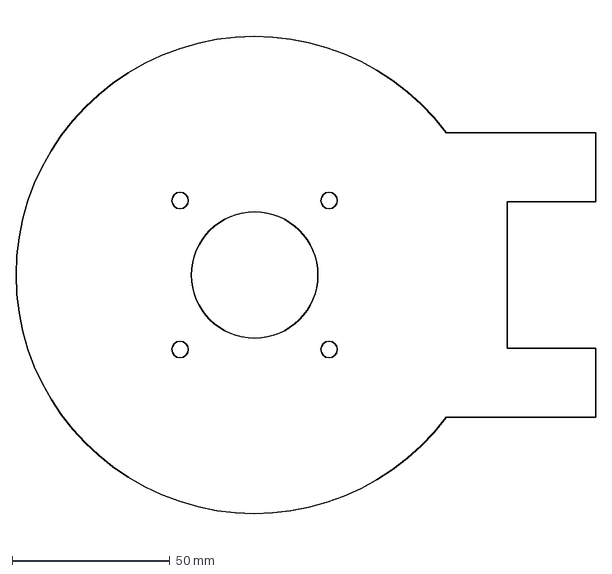
[picture p34: CAD file, 2026-10-31]
output/dxf/fore_plate_J3.dxf
183.5 x 163.8 mm
