KoreanJD/orchard-rover/output/elbow/parts/cycloid_disc.step

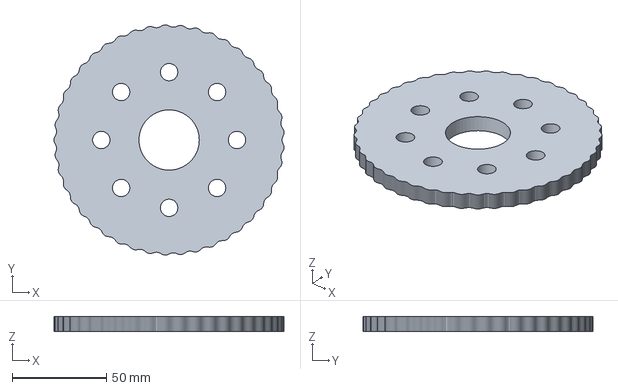
[picture p35: CAD file, 2026-10-31]
output/elbow/parts/cycloid_disc.step
122.1 x 122.1 x 8.00 mm
