KoreanJD/orchard-rover/output/parts/rocker_plate.step

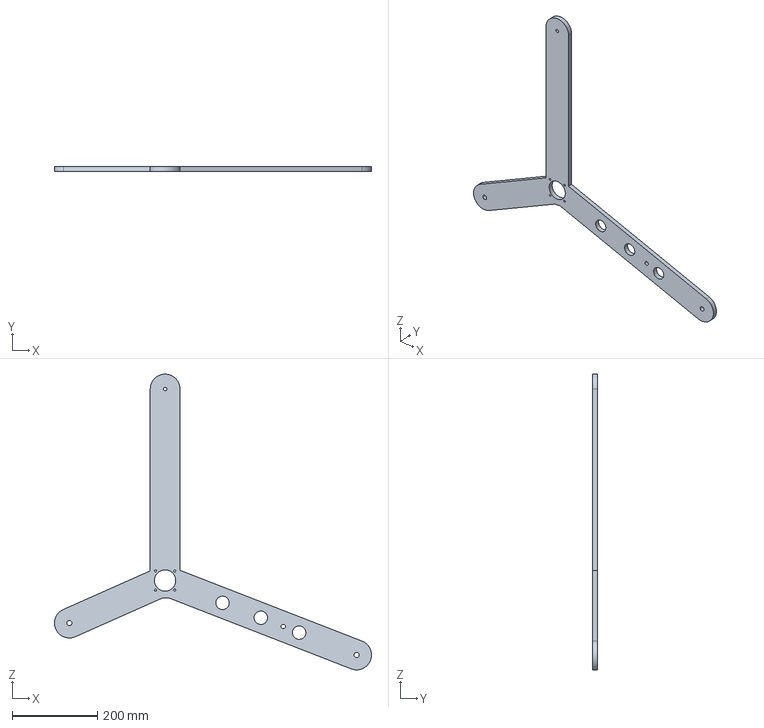
[picture p36: CAD file, 2026-10-31]
output/parts/rocker_plate.step
744.9 x 12.0 x 695.0 mm
