KoreanJD/orchard-rover/output/shoulder/parts/nema23_brake.step

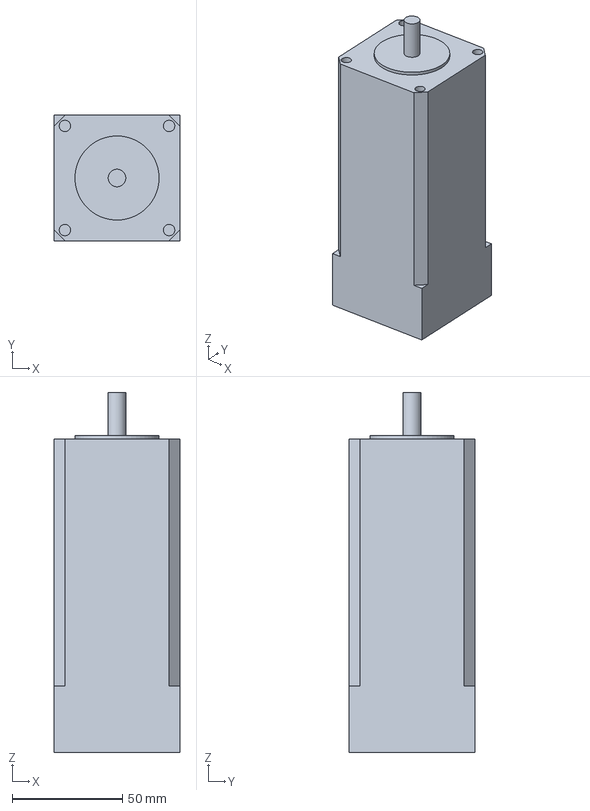
[picture p37: CAD file, 2026-10-31]
output/shoulder/parts/nema23_brake.step
57.0 x 57.0 x 163.0 mm
