KoreanJD/orchard-rover/output/urdf/orchard_rover_description/meshes/visual/j1_link.stl

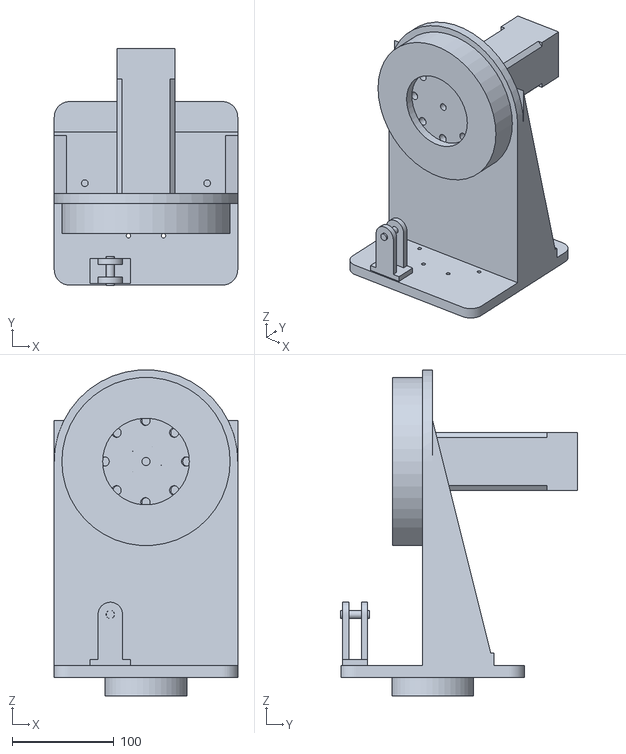
[picture p39: CAD file, 2026-10-31]
output/urdf/orchard_rover_description/meshes/visual/j1_link.stl
180.0 x 232.2 x 319.8
