KoreanJD/orchard-rover/output/dxf/upper_plate_J3.dxf

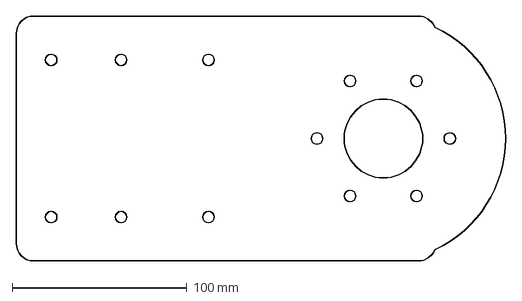
[picture p40: CAD file, 2026-10-31]
output/dxf/upper_plate_J3.dxf
280.0 x 140.0 mm
