KoreanJD/orchard-rover/output/elbow/parts/nema23_brake.step

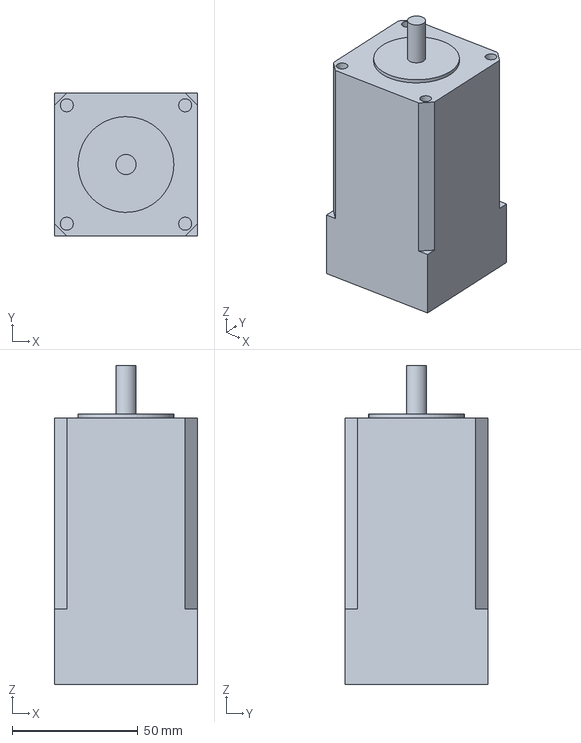
[picture p41: CAD file, 2026-10-31]
output/elbow/parts/nema23_brake.step
57.0 x 57.0 x 127.0 mm
