KoreanJD/orchard-rover/output/parts/diff_bar.step

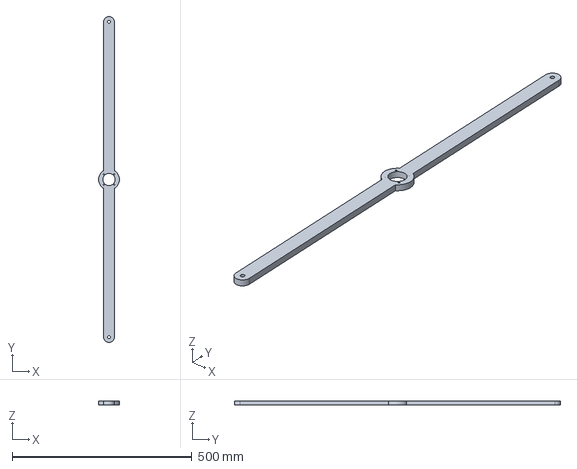
[picture p42: CAD file, 2026-10-31]
output/parts/diff_bar.step
57.9 x 908.0 x 12.0 mm
