KoreanJD/orchard-rover/output/shoulder/parts/cycloid_disc.step

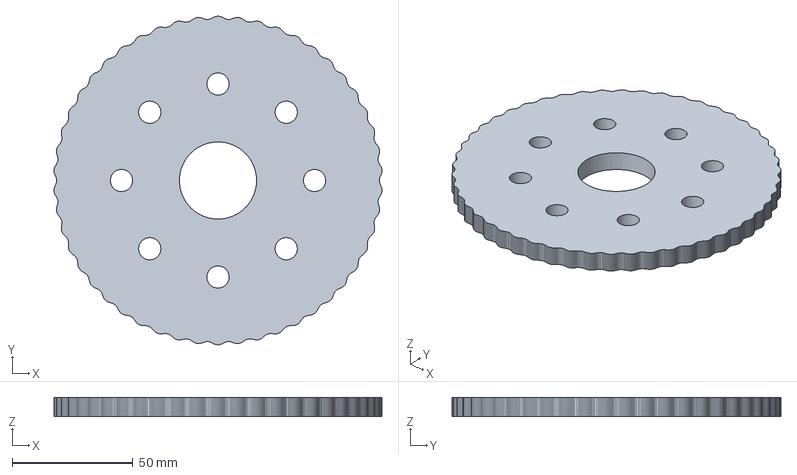
[picture p43: CAD file, 2026-10-31]
output/shoulder/parts/cycloid_disc.step
135.9 x 136.2 x 8.00 mm
