KoreanJD/orchard-rover/output/urdf/orchard_rover_description/meshes/collision/upper_arm.stl

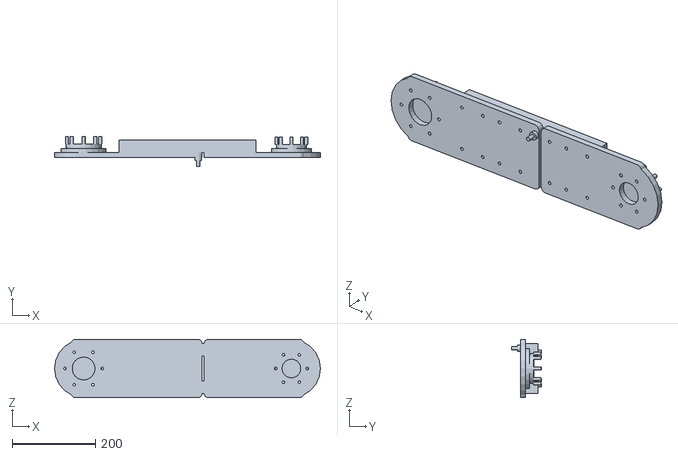
[picture p44: CAD file, 2026-10-31]
output/urdf/orchard_rover_description/meshes/collision/upper_arm.stl
640.0 x 72.0 x 140.0
