KoreanJD/orchard-rover/output/dxf/shoulder_bracket_gusset.dxf

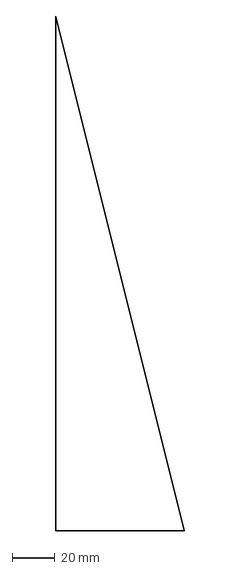
[picture p45: CAD file, 2026-10-31]
output/dxf/shoulder_bracket_gusset.dxf
60.0 x 240.0 mm
