KoreanJD/orchard-rover/output/elbow/parts/output_flange.step

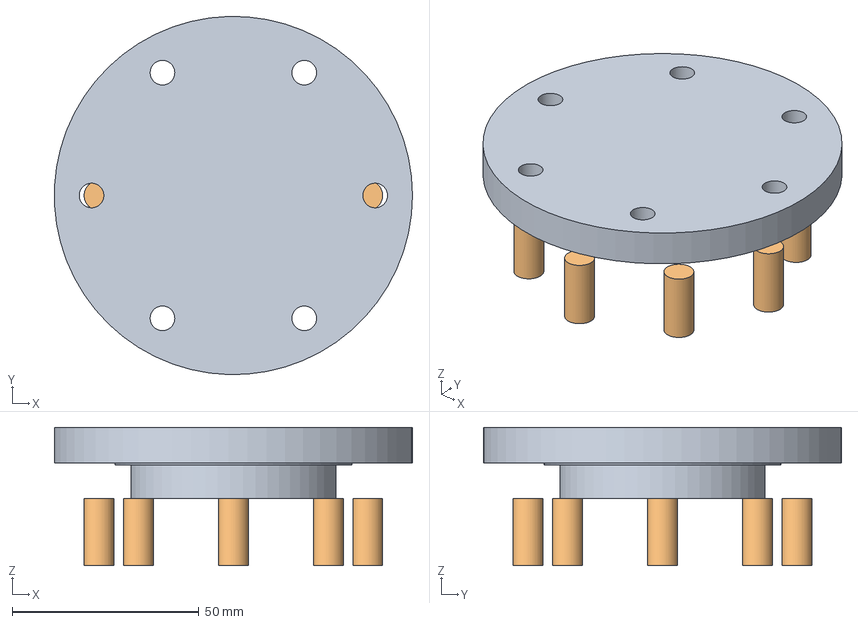
[picture p46: CAD file, 2026-10-31]
output/elbow/parts/output_flange.step
95.9 x 96.0 x 37.0 mm
