KoreanJD/orchard-rover/output/parts/bogie_plate.step

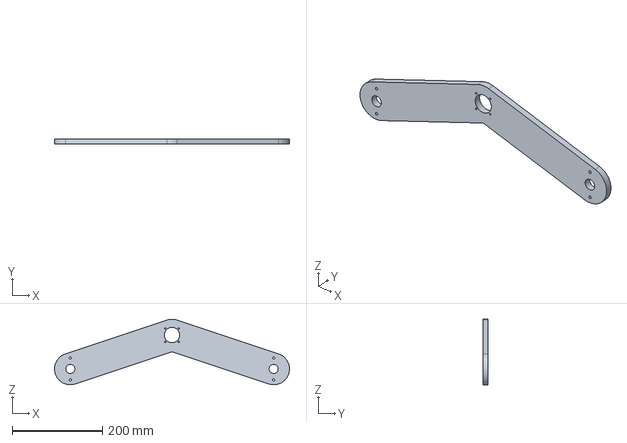
[picture p47: CAD file, 2026-10-31]
output/parts/bogie_plate.step
519.9 x 12.0 x 145.0 mm
