KoreanJD/orchard-rover/output/shoulder/parts/ring_housing.step

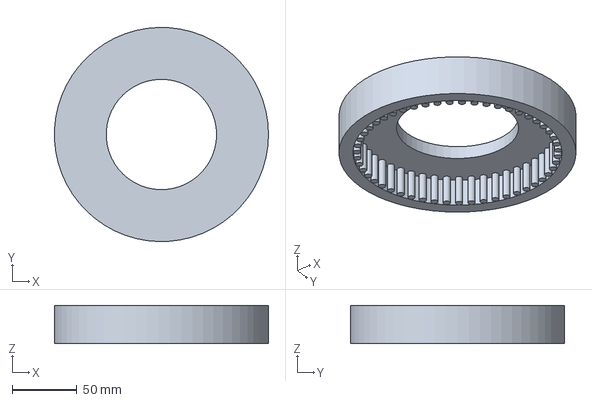
[picture p48: CAD file, 2026-10-31]
output/shoulder/parts/ring_housing.step
164.9 x 164.9 x 29.5 mm
