KoreanJD/orchard-rover/output/urdf/orchard_rover_description/meshes/collision/flange.stl

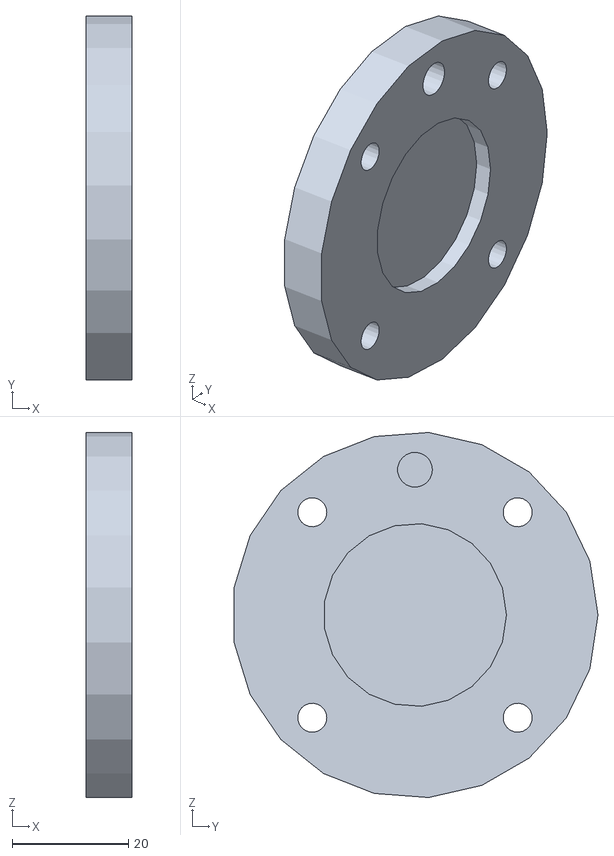
[picture p49: CAD file, 2026-10-31]
output/urdf/orchard_rover_description/meshes/collision/flange.stl
8.00 x 62.6 x 62.8
