KoreanJD/orchard-rover/output/dxf/shoulder_bracket.dxf

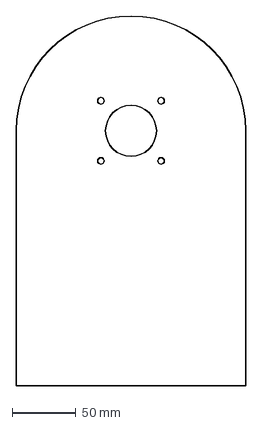
[picture p50: CAD file, 2026-10-31]
output/dxf/shoulder_bracket.dxf
180.0 x 290.0 mm
