KoreanJD/orchard-rover/output/parts/wheel_drive_ref.step

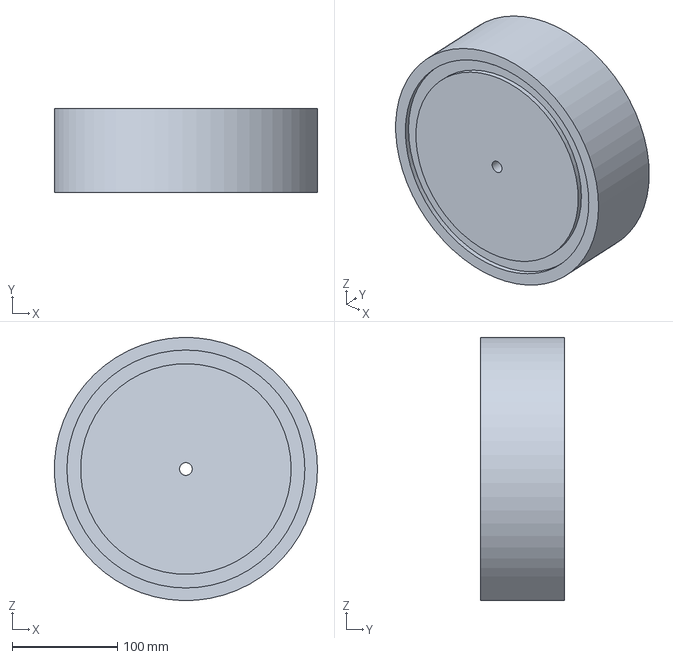
[picture p51: CAD file, 2026-10-31]
output/parts/wheel_drive_ref.step
249.8 x 80.0 x 249.9 mm
