KoreanJD/orchard-rover/output/shoulder/parts/output_flange.step

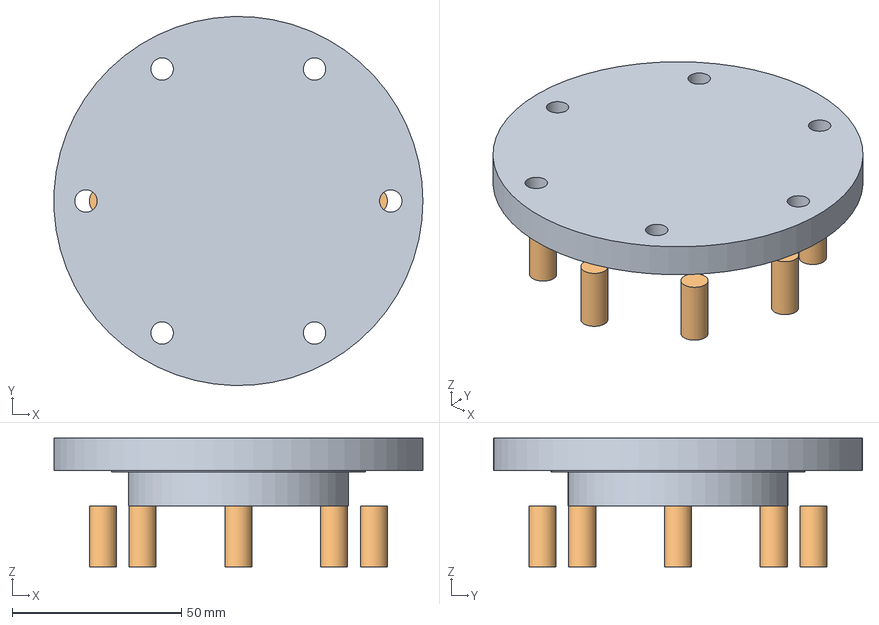
[picture p52: CAD file, 2026-10-31]
output/shoulder/parts/output_flange.step
108.9 x 109.0 x 38.0 mm
