KoreanJD/orchard-rover/output/urdf/orchard_rover_description/meshes/collision/forearm_tube.stl

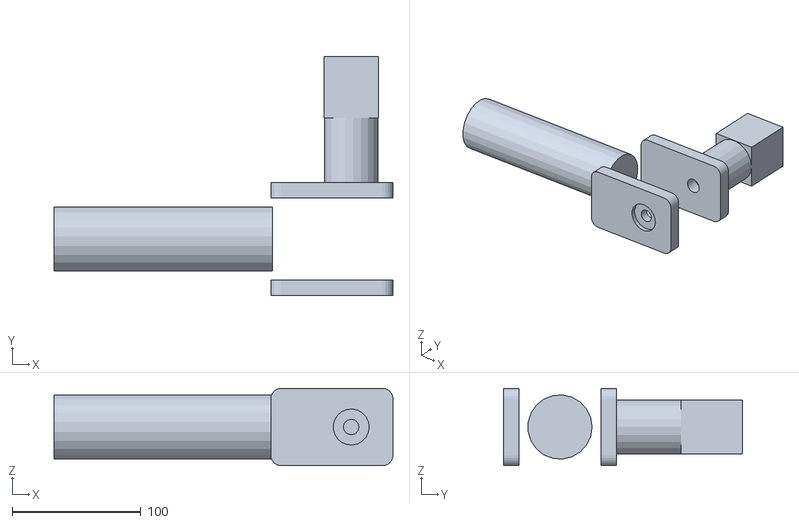
[picture p53: CAD file, 2026-10-31]
output/urdf/orchard_rover_description/meshes/collision/forearm_tube.stl
263.5 x 186.0 x 60.0
