KoreanJD/orchard-rover/output/dxf/fore_offset_bracket.dxf

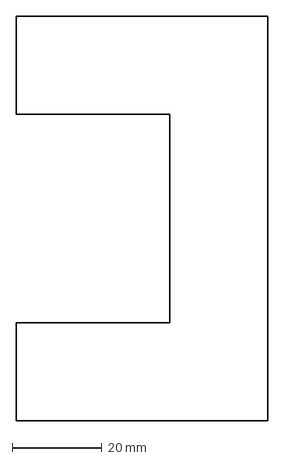
[picture p54: CAD file, 2026-10-31]
output/dxf/fore_offset_bracket.dxf
56.0 x 90.0 mm
