KoreanJD/orchard-rover/output/urdf/orchard_rover_description/meshes/collision/forearm_root.stl

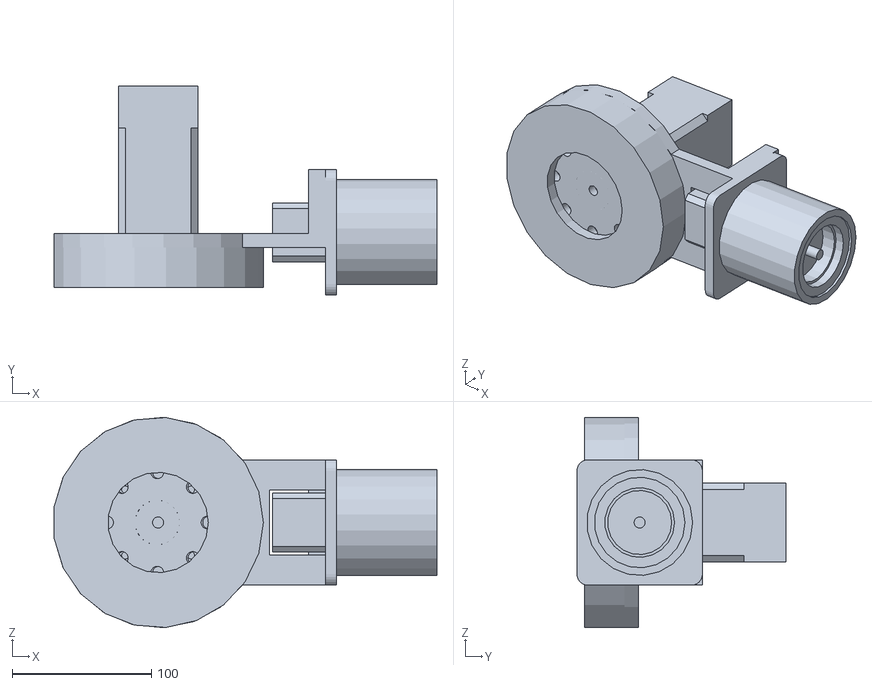
[picture p55: CAD file, 2026-10-31]
output/urdf/orchard_rover_description/meshes/collision/forearm_root.stl
274.7 x 150.0 x 150.8
