KoreanJD/orchard-rover/output/urdf/orchard_rover_description/meshes/visual/forearm_root.stl

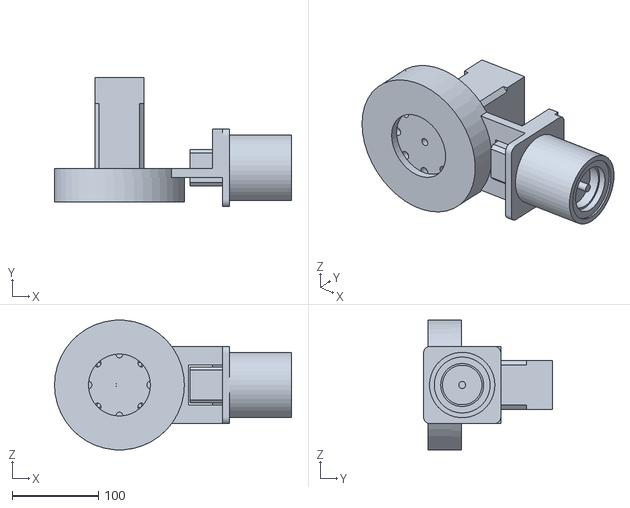
[picture p56: CAD file, 2026-10-31]
output/urdf/orchard_rover_description/meshes/visual/forearm_root.stl
275.5 x 150.0 x 150.8
