KoreanJD/orchard-rover/output/dxf/j1_turret.dxf

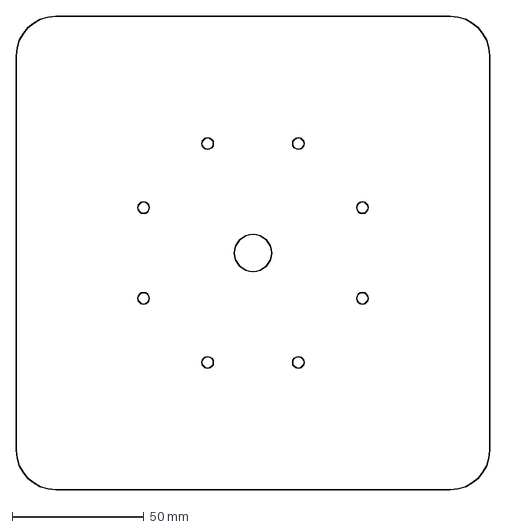
[picture p57: CAD file, 2026-10-31]
output/dxf/j1_turret.dxf
180.0 x 180.0 mm
