KoreanJD/orchard-rover/output/parts/pivot_block.step

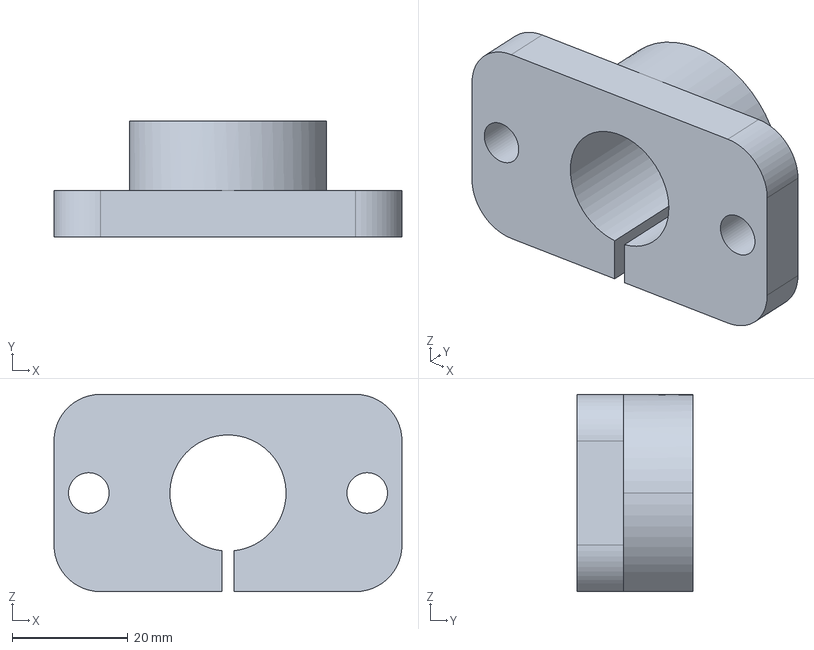
[picture p58: CAD file, 2026-10-31]
output/parts/pivot_block.step
60.0 x 20.0 x 34.0 mm
