KoreanJD/orchard-rover/output/urdf/orchard_rover_description/meshes/collision/wrist.stl

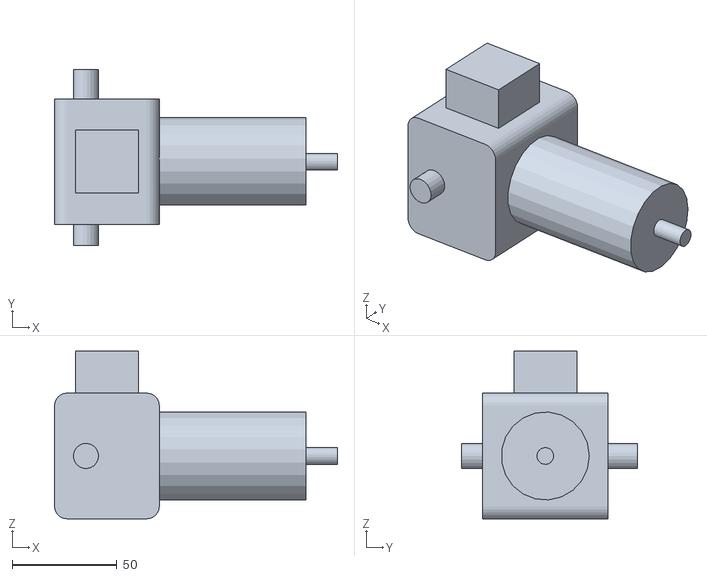
[picture p59: CAD file, 2026-10-31]
output/urdf/orchard_rover_description/meshes/collision/wrist.stl
135.0 x 84.0 x 80.0
