KoreanJD/orchard-rover/output/dxf/j1_base_plate.dxf

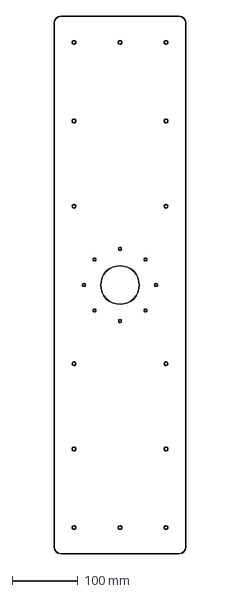
[picture p60: CAD file, 2026-10-31]
output/dxf/j1_base_plate.dxf
200.0 x 820.0 mm
