KoreanJD/orchard-rover/output/parts/front_fork.step

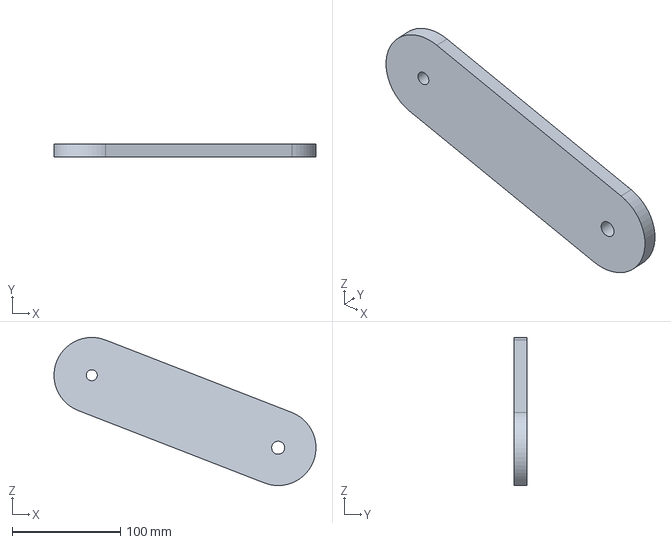
[picture p61: CAD file, 2026-10-31]
output/parts/front_fork.step
242.4 x 12.0 x 137.1 mm
