KoreanJD/orchard-rover/output/parts/link_rod.step

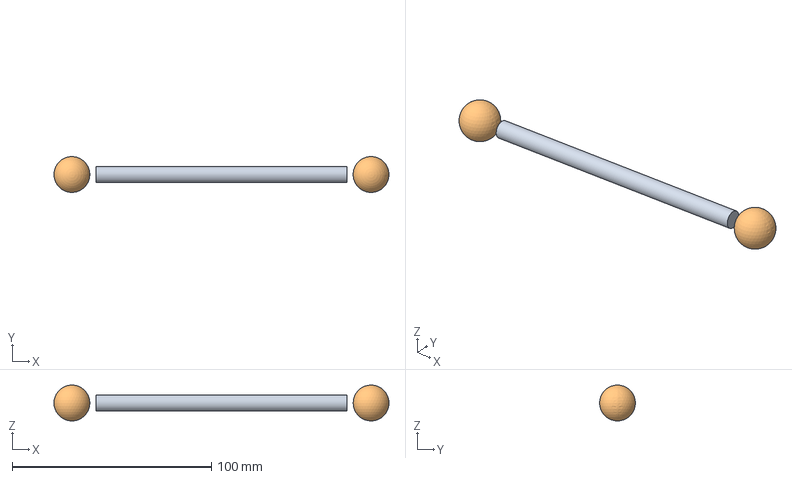
[picture p62: CAD file, 2026-10-31]
output/parts/link_rod.step
168.0 x 17.9 x 18.0 mm
