KoreanJD/orchard-rover/output/parts/shaft_collar.step

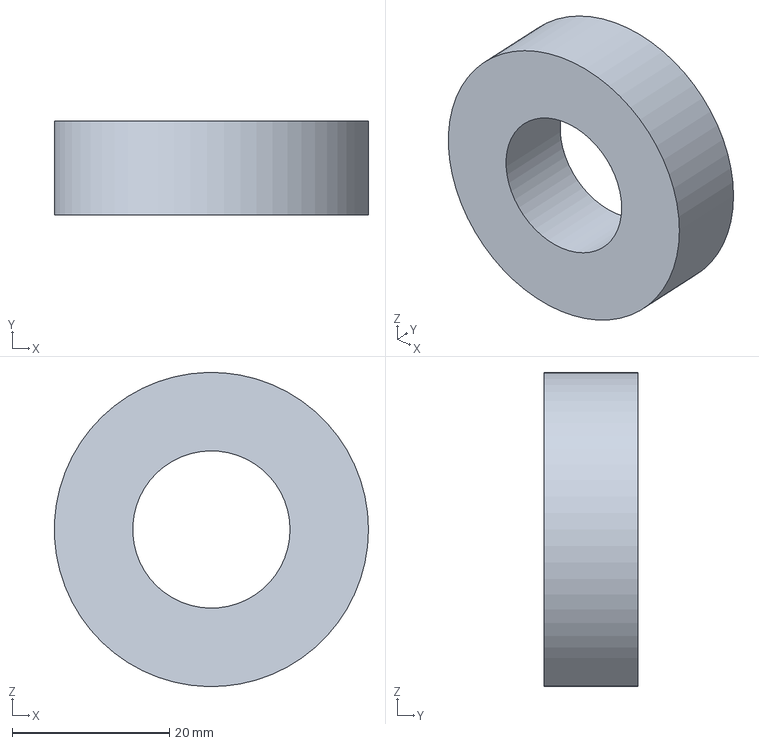
[picture p63: CAD file, 2026-10-31]
output/parts/shaft_collar.step
40.0 x 12.0 x 40.0 mm
