KoreanJD/orchard-rover/(list of files, cad)

Other CAD files:
output/urdf/orchard_rover_description/meshes/visual/upper_arm.stl
output/urdf/orchard_rover_description/meshes/visual/flange.stl
output/elbow/parts/eccentric_cam.step
output/urdf/orchard_rover_description/meshes/visual/forearm_tube.stl
output/parts/wheel_ref.step
output/urdf/orchard_rover_description/meshes/visual/wrist.stl
output/dxf/bogie_plate.dxf
output/dxf/diff_bar.dxf
output/dxf/front_fork.dxf
output/dxf/rocker_plate.dxf
output/elbow/cycloid_disc.dxf
output/fusion/orchard_robot_full.f3d
output/fusion/rocker_bogie_assembly.f3d
output/fusion/shoulder_assembly.f3d
output/rocker_bogie_assembly.stl
output/shoulder/cycloid_disc.dxf
