KoreanJD/orchard-rover/output/urdf/orchard_rover_description/urdf/orchard_rover.urdf

<?xml version="1.0"?>
<robot name="orchard_rover">
  <!-- orchard_rover.urdf_export 생성. 단위 m, 메시는 mm STL × 0.001 -->
  <link name="base_link">
    <inertial>
      <origin xyz="0.0251488228 0 0.25777979" rpy="0 0 0"/>
      <mass value="96.3517132"/>
      <inertia ixx="26.7110624" ixy="0" ixz="-1.01027991" iyy="17.1942584" iyz="0" izz="33.67069"/>
    </inertial>
    <visual>
      <origin xyz="0 0 0" rpy="0 0 0"/>
      <geometry><mesh filename="package://orchard_rover_description/meshes/visual/base_link.stl" scale="0.001 0.001 0.001"/></geometry>
    </visual>
    <collision>
      <origin xyz="0 0 0" rpy="0 0 0"/>
      <geometry><mesh filename="package://orchard_rover_description/meshes/collision/base_link.stl" scale="0.001 0.001 0.001"/></geometry>
    </collision>
  </link>
  <link name="j1_link">
    <inertial>
      <origin xyz="-0.000352136866 0.0106471939 -0.080129359" rpy="0 0 0"/>
      <mass value="5.92144628"/>
      <inertia ixx="0.0677475533" ixy="-0.000182102707" ixz="-0.000196846173" iyy="0.0682871591" iyz="-0.00318225592" izz="0.0254036824"/>
    </inertial>
    <visual>
      <origin xyz="0 0 0" rpy="0 0 0"/>
      <geometry><mesh filename="package://orchard_rover_description/meshes/visual/j1_link.stl" scale="0.001 0.001 0.001"/></geometry>
    </visual>
    <collision>
      <origin xyz="0 0 0" rpy="0 0 0"/>
      <geometry><mesh filename="package://orchard_rover_description/meshes/collision/j1_link.stl" scale="0.001 0.001 0.001"/></geometry>
    </collision>
  </link>
  <link name="upper_arm">
    <inertial>
      <origin xyz="0.245560731 -0.0468850893 6.17477502e-05" rpy="0 0 0"/>
      <mass value="4.91584945"/>
      <inertia ixx="0.00868362492" ixy="0.000256359384" ixz="-9.16256813e-06" iyy="0.145417132" iyz="6.8183985e-06" izz="0.13806107"/>
    </inertial>
    <visual>
      <origin xyz="0 0 0" rpy="0 0 0"/>
      <geometry><mesh filename="package://orchard_rover_description/meshes/visual/upper_arm.stl" scale="0.001 0.001 0.001"/></geometry>
    </visual>
    <collision>
      <origin xyz="0 0 0" rpy="0 0 0"/>
      <geometry><mesh filename="package://orchard_rover_description/meshes/collision/upper_arm.stl" scale="0.001 0.001 0.001"/></geometry>
    </collision>
  </link>
  <link name="forearm_root">
    <inertial>
      <origin xyz="0.0480602062 0.00548406647 0" rpy="0 0 0"/>
      <mass value="3.71421336"/>
      <inertia ixx="0.00774008989" ixy="0.000725466416" ixz="0" iyy="0.0235033932" iyz="0" izz="0.0248455022"/>
    </inertial>
    <visual>
      <origin xyz="0 0 0" rpy="0 0 0"/>
      <geometry><mesh filename="package://orchard_rover_description/meshes/visual/forearm_root.stl" scale="0.001 0.001 0.001"/></geometry>
    </visual>
    <collision>
      <origin xyz="0 0 0" rpy="0 0 0"/>
      <geometry><mesh filename="package://orchard_rover_description/meshes/collision/forearm_root.stl" scale="0.001 0.001 0.001"/></geometry>
    </collision>
  </link>
  <link name="forearm_tube">
    <inertial>
      <origin xyz="0.25601847 0.0383089033 0" rpy="0 0 0"/>
      <mass value="1.05579558"/>
      <inertia ixx="0.00344557785" ixy="-0.001859786" ixz="0" iyy="0.00608919381" iyz="0" izz="0.00909023218"/>
    </inertial>
    <visual>
      <origin xyz="0 0 0" rpy="0 0 0"/>
      <geometry><mesh filename="package://orchard_rover_description/meshes/visual/forearm_tube.stl" scale="0.001 0.001 0.001"/></geometry>
    </visual>
    <collision>
      <origin xyz="0 0 0" rpy="0 0 0"/>
      <geometry><mesh filename="package://orchard_rover_description/meshes/collision/forearm_tube.stl" scale="0.001 0.001 0.001"/></geometry>
    </collision>
  </link>
  <link name="wrist">
    <inertial>
      <origin xyz="0.0317566895 6.79149833e-05 0.00257357269" rpy="0 0 0"/>
      <mass value="0.755370154"/>
      <inertia ixx="0.000410515285" ixy="1.62914838e-06" ixz="4.22950043e-05" iyy="0.00103497733" iyz="1.32026728e-07" izz="0.000976480965"/>
    </inertial>
    <visual>
      <origin xyz="0 0 0" rpy="0 0 0"/>
      <geometry><mesh filename="package://orchard_rover_description/meshes/visual/wrist.stl" scale="0.001 0.001 0.001"/></geometry>
    </visual>
    <collision>
      <origin xyz="0 0 0" rpy="0 0 0"/>
      <geometry><mesh filename="package://orchard_rover_description/meshes/collision/wrist.stl" scale="0.001 0.001 0.001"/></geometry>
    </collision>
  </link>
  <link name="flange">
    <inertial>
      <origin xyz="-0.0042758675 0 -0.000194529751" rpy="0 0 0"/>
      <mass value="0.0588655727"/>
      <inertia ixx="3.1266243e-05" ixy="0" ixz="1.4610093e-08" iyy="1.57884288e-05" iyz="0" izz="1.6076934e-05"/>
    </inertial>
    <visual>
      <origin xyz="0 0 0" rpy="0 0 0"/>
      <geometry><mesh filename="package://orchard_rover_description/meshes/visual/flange.stl" scale="0.001 0.001 0.001"/></geometry>
    </visual>
    <collision>
      <origin xyz="0 0 0" rpy="0 0 0"/>
      <geometry><mesh filename="package://orchard_rover_description/meshes/collision/flange.stl" scale="0.001 0.001 0.001"/></geometry>
    </collision>
  </link>
  <link name="tool0"/>
  <joint name="J1" type="revolute">
    <parent link="base_link"/>
    <child link="j1_link"/>
    <origin xyz="0.3 0 0.958" rpy="0 0 0"/>
    <axis xyz="0 0 1"/>
    <limit lower="-3.14159265" upper="3.14159265" effort="24" velocity="0.785398163"/>
  </joint>
  <joint name="J2" type="revolute">
    <parent link="j1_link"/>
    <child link="upper_arm"/>
    <origin xyz="0 0 0" rpy="0 0 0"/>
    <axis xyz="0 -1 0"/>
    <limit lower="-0.34906585" upper="1.57079633" effort="80" velocity="0.523598776"/>
  </joint>
  <joint name="J3" type="revolute">
    <parent link="upper_arm"/>
    <child link="forearm_root"/>
    <origin xyz="0.5 0 0" rpy="0 0 0"/>
    <axis xyz="0 -1 0"/>
    <limit lower="-2.0943951" upper="2.0943951" effort="54" velocity="0.523598776"/>
  </joint>
  <joint name="J4" type="revolute">
    <parent link="forearm_root"/>
    <child link="forearm_tube"/>
    <origin xyz="0.12 0 0" rpy="0 0 0"/>
    <axis xyz="1 0 0"/>
    <limit lower="-3.14159265" upper="3.14159265" effort="11.5" velocity="0.785398163"/>
  </joint>
  <joint name="J5" type="revolute">
    <parent link="forearm_tube"/>
    <child link="wrist"/>
    <origin xyz="0.302 0 0" rpy="0 0 0"/>
    <axis xyz="0 -1 0"/>
    <limit lower="-1.91986218" upper="1.91986218" effort="11.5" velocity="0.785398163"/>
  </joint>
  <joint name="J6" type="revolute">
    <parent link="wrist"/>
    <child link="flange"/>
    <origin xyz="0.128 0 0" rpy="0 0 0"/>
    <axis xyz="1 0 0"/>
    <limit lower="-3.14159265" upper="3.14159265" effort="3.6" velocity="1.04719755"/>
  </joint>
  <joint name="tool0_fixed" type="fixed">
    <parent link="flange"/>
    <child link="tool0"/>
    <origin xyz="0 0 0" rpy="0 0 0"/>
  </joint>
</robot>
