KoreanJD/orchard-rover/(commit log)

2026-10-26 Initial import: rocker-bogie rover + 6-axis arm parametric CAD
    - orchard_rover/: CadQuery sources (suspension, cycloidal joints, wrist,
    arm assembly, J1 base, full-robot assembly), analysis (torque,
    workspace/IK, cable routing, transport-pose interference)
    - tests/: 34 pytest checks (statics, differential kinematics, cycloid
    geometry, routing constraints, assembly integrity)
    - docs/: design records (suspension, arm spec, cable routing) + images
    - output/: generated STEP/STL/DXF/PNG/GIF and reports
    Claude-Session: https://claude.ai/code/session_01HK6uTMpRC136yFsX2LVMfY
    [arm_J2_J3_assembly.step, bogie_plate.dxf, bogie_plate.step, cycloid_disc.dxf, cycloid_disc.step, diff_bar.step, diff_post.step, eccentric_cam.step]
2026-10-28 Fix assembly constraint errors found in Fusion interference check
    Geometry checked in Fusion (interference, contact, shaft/hole coaxiality)
    showed placement and hole-origin bugs; fixed and re-exported.
    - arm_assembly: side plates / forearm plate were offset +PLATE_T (XZ
    extrude(-t) goes +Y) and sat inside the J2/J3 flanges; J3 module was
    offset an extra -PLATE_T. Plates now flush on flange / adapter faces.
    - Hole origins: faces().workplane() inherited origins moved by .center()
    (and local x = -X on >Y faces), so plate bolt/through holes, eccentric
    cam bore (0.6 mm off motor axis), shoulder bracket motor/anchor holes
    and ISO flange centering recess were misplaced. Use explicit orig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
    [arm_J2_J3_assembly.step, bogie_plate.dxf, bogie_plate.step, cycloid_disc.dxf, cycloid_disc.step, diff_bar.step, diff_post.step, eccentric_cam.step]
2026-10-29 Resolve arm layout design issues: J3 mounting, rails, J2 bracket, gas spring
    Design decisions from the Fusion constraint check (items 1-5):
    - Drop joint-module placeholders (upper_arm_plate, gas_spring) from the
    arm assembly; they stay in the standalone shoulder_assembly.step.
    - J3 mounted like J2: output flange on the upper side plate +Y face,
    ring/motor on the forearm. Forearm plate takes the J3 adapter slot
    (ADAPTER_T); J4 housing bolts to a YZ bracket with a J4-motor window,
    J4 housing moved to J3 axis +120 so the J4 motor clears the J3 ring.
    J5 axis and flange position unchanged.
    - Upper rails shortened to X 85..415 to clear the J2/J3 ring housings.
    - J1 shoulder bracket (10t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
    [arm_J2_J3_assembly.step, bogie_plate.dxf, bogie_plate.step, cycloid_disc.dxf, cycloid_disc.step, diff_bar.step, diff_post.step, eccentric_cam.step]
2026-10-29 Add J3 elbow joint outputs
    output/elbow/ is written by `python -m orchard_rover.shoulder_joint`
    (elbow_params: 45:1 cycloid, NEMA23 3.0 N·m) but was never committed:
    the script previously stopped at the PNG step of the J2 export because
    the cairo runtime was missing. Files keep the export's shoulder_* names.
    [cycloid_disc.dxf, cycloid_disc.step, eccentric_cam.step, nema23_brake.step, output_flange.step, ring_housing.step, shoulder_assembly.step]
2026-10-29 Restore 12-degree pose for rocker-bogie assembly outputs
    The committed rocker_bogie_assembly.step/stl and views were exported with
    `rocker_bogie_cad --pose 12` (left rocker raised, as in the README), but
    7f9ce93 regenerated them with the default flat pose. Re-export at 12 deg;
    geometry otherwise includes the stepped rocker shaft from 7f9ce93.
    [bogie_plate.dxf, bogie_plate.step, diff_bar.step, diff_post.step, link_rod.step, pivot_block.step, rocker_bogie_assembly.step, rocker_bogie_assembly.stl]
2026-10-29 Add Fusion archives of the current assemblies
    output/fusion/*.f3d: orchard_robot_full, shoulder_assembly and
    rocker_bogie_assembly (12 deg pose) imported from the current STEP files
    into Fusion with a Z-up view and exported as Fusion archives.
    [orchard_robot_full.f3d, rocker_bogie_assembly.f3d, shoulder_assembly.f3d]
2026-10-29 Close remaining constraint gaps: joint internals, wrist, bearings, motion check
    Remaining items and previously unchecked areas from the Fusion check:
    - Cycloid joints (J2/J3): ring housing now starts on the adapter face and
    carries an output-bearing outer-race seat (was floating 1 mm, outer race
    unsupported); flange cap relieved 0.5 so it only loads the inner race;
    cam bearings (6002 x2) added.
    - Wrist: J4 housing bored (motor clearance / gearbox pilot / 6810 seat),
    OD 64 -> 76 so the 65 mm bearing fits; output hub through the bearing
    with a bore for the gearbox shaft. Wrist block pocketed for the J6
    motor, J5 stub shafts to the gearbox and support bearing.
    - Suspension: rocker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
    [arm_J2_J3_assembly.step, cycloid_disc.dxf, cycloid_disc.step, eccentric_cam.step, nema23_brake.step, orchard_robot_full.f3d, orchard_robot_full.step, output_flange.step]
2026-10-29 Add part strength checks, fix bracket gussets, export plate DXFs
    - arm_check.plate_strength(): stress/safety factor for the parts changed
    in the constraint fixes (J1 bracket 10t, forearm plate window section,
    J4 housing bearing seat, J5 stub shafts), horizontal reach, 3 kg tool,
    dynamic x1.5, yield-based. All SF >= 85 except bracket (93 after fix).
    - J1 bracket gussets were modelled as horizontal triangles (no
    out-of-plane stiffness). The plate alone moved the arm tip 0.90 mm
    (79% of the arm's own 1.14 mm deflection). Gussets are now vertical
    12t, 60 deep x 240 high: tip contribution 0.06 mm.
    - plate_dxf.py: mid-thickness DXF for upper side plates J2/J3, forearm
    plate, offset b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
    [fore_offset_bracket.dxf, fore_plate_J3.dxf, j1_base_plate.dxf, j1_turret.dxf, orchard_robot_full.f3d, orchard_robot_full.step, shoulder_bracket.dxf, shoulder_bracket_gusset.dxf]
2026-10-29 Suspension: arm load cases, Ø20 rocker shaft, front-wheel outboard fork
    The suspension was sized for the 60 kg vehicle alone. With the arm (15 kg)
    and tool (3 kg) mounted at J1 X=+300, load cases show the arm's pitch
    moment (carried through the differential links) loading the front wheels:
    worst front axle SF 1.59, wheel 2.14, rocker out-of-plane 2.35, rocker
    shaft 2.49 (criterion 2.5, dynamic x3).
    - rocker_bogie_params: load_cases() (vehicle only, transport, reach
    front/diag/side/rear) and wheel_loads(mass, cg_x, cg_y); safety_factors()
    takes the worst case and side. Front axle check uses the hub-motor M12
    axle (10 mm flats, assumed 8.8 grade) simply supported by the rocker
    plate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
    [bogie_plate.dxf, bogie_plate.step, diff_bar.step, diff_post.step, front_fork.dxf, front_fork.step, link_rod.step, orchard_robot_full.f3d]
2026-10-29 Add MoveIt2 description package: URDF, SRDF, link meshes
    - urdf_export.py builds a ROS 2 ament package (orchard_rover_description)
    from the CadQuery assembly: links grouped by the same chain stages as
    the pose/motion checks (base_link, j1_link, upper_arm, forearm_root,
    forearm_tube, wrist, flange, tool0); joint axes and signs match
    arm_pose_render.place() (J1 +Z, J2/J3/J5 -Y, J4/J6 +X).
    - Limits from the joint range table, effort/velocity from the actuator
    table. Visual STL 0.5 mm, collision STL 3 mm (triangulation cleared per
    export so the coarser tolerance applies). Inertia from CAD volume x Al
    density (planning approximation).
    - SRDF: arm chain base_link -> tool0, home and t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
    [base_link.stl, flange.stl, forearm_root.stl, forearm_tube.stl, j1_link.stl, orchard_rover.urdf, upper_arm.stl, wrist.stl]
2026-10-30 Fix MISUMI catalog mismatches found by cross-checking misumi-ec.com
    Cross-checked every catalogue part against kr.misumi-ec.com:
    - SHF20: catalogue T=20 is the overall axial length including the
    8 mm flange; the model used 8 + 20 = 28. Boss is now 12, flange height
    A34. Stack-up shrinks by 8, rocker shaft SF 4.15 -> 4.86.
    - Set collar: "SCS20" on MISUMI is a third-party shackle. The collar is
    PSCS20-12 (ID 20 / OD 40 / W 12); model OD 32 -> 40.
    - Upper arm rails: HFS5-3030 does not exist; 30x30 is HFS6-3030
    (A 333 mm2, I 2.83e4, 0.9 kg/m). Renamed; section values updated.
    - Series-5 slot T-nuts (HNTT5/HNTP5) are M3-M5 only, and HFS5-4040 has
    two slots per face at +-10. Bolt holes w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
    [base_link.stl, bogie_plate.dxf, bogie_plate.step, diff_bar.step, diff_post.step, fore_offset_bracket.dxf, fore_plate_J3.dxf, front_fork.dxf]
2026-10-30 J2 gas spring: MISUMI FGSS22120C with re-placed anchors
    The previous balancer (r100 / h180, 350 N) needed a 174-279 mm spring
    (length ratio 1.6); no MISUMI gas spring fits (FGSS forces are 49-490 N
    in steps, stroke 100 already starts at 286 mm). Searched all 17 FGSS
    sizes against every mountable anchor position and picked FGSS22120C
    (stroke 120, 320-440 mm, 392 N @ Lmax-10, dia 22):
    - Base anchor at arm-frame (-35, -150): clevis 50 above the J1 turret.
    - Arm anchor r280 / +10 deg on the J2 side plate (X 276, Z 49); the J2
    side plate is extended from X 210 to 285 (5 mm short of the J3 plate),
    with an extra rail bolt pair at X 240.
    - Over the full J2 range (-20..90 deg) the spring stays a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
    [arm_J2_J3_assembly.step, cycloid_disc.dxf, cycloid_disc.step, eccentric_cam.step, fore_offset_bracket.dxf, fore_plate_J3.dxf, j1_base_plate.dxf, j1_link.stl]
2026-10-30 Frame: separate MISUMI HFS5-4040 profile members with butt joints
    The frame was a single fused block of 40x40 solid bars (a reference for
    the suspension mounting points). It is now built from catalogue profile
    members:
    - hfs5_4040_section(): 40x40 with two slots per face at +-10 (opening 6)
    and the four dia 4.2 corner holes from the MISUMI drawing; T-slot
    interior and centre cavity approximated. Catalogue data (1.28 kg/m,
    A 472 mm2, I 8.89e4) is used for mass.
    - frame_members(): side rails 1000 x4 run through; end cross members,
    differential cross member and J1 cross members (720 x7) butt against
    the rail inner faces; posts 350 x4 butt onto/under the rails. 15
    members, 10.44 m,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
    [base_link.stl, orchard_robot_full.f3d, orchard_robot_full.step, orchard_rover.urdf, rocker_bogie_assembly.f3d, rocker_bogie_assembly.step, rocker_bogie_assembly.stl]
2026-10-31 Idler wheels: SFJ20 axle clamped by SHF20 holder, retained by PSCS20-12
    The idler spec said 6003ZZ (bore 17) while the axle was Ø16, and the stub
    axle only sat in a clearance hole in the bogie plate with nothing clamping
    it or keeping the wheel on.
    - Axle Ø16 -> SFJ20, hub bearing bore 20 (modelled 6004ZZ x2 in pockets)
    - SHF20 holder on the bogie plate outer face, rotated 90° so the bolt row is
    vertical and the wheel-load moment goes into M6 bolt tension (plate tapped)
    - Stack: plate | holder T20 | spacer 4 | wheel 80 | washer 2 | PSCS20-12
    - wheel_gap 16 -> 24 for the holder; track 1016 -> 1032
    - New SF: idler_axle 8.7, idler_holder_bolt 22.9; front axle 2.72 -> 2.62
    - Tests for the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
    [base_link.stl, bogie_plate.dxf, bogie_plate.step, orchard_robot_full.f3d, orchard_robot_full.step, orchard_rover.urdf, rocker_bogie_assembly.f3d, rocker_bogie_assembly.step]
2026-10-31 Rocker/bogie/diff pivots: bolted MISUMI BGRBB holders replace integral bosses
    The rocker plate, bogie plate and diff bar carried integral bearing bosses
    that could not be cut from 12t plate. They are now single-thickness plates
    (waterjet + taps) with commercial flanged holder sets bolted on:
    - Rocker pivot: BGRBB6004DD-40 (M6 x4), flange on plate inner face
    - Bogie pivot: BGRBB6001DD-25 (M4 x4), flange on plate outer face
    - Diff bar: BGRBB6001DD-25 (M4 x4) on a center pad, new diff_bar.dxf
    Inner-ring spacers locate each bearing axially and keep the rotating holders
    clear of SHF20, the shaft collar, the rocker plate and the diff post.
    plate_gap 6 -> 8; track 1032 -> 1058, overall width 1182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
    [base_link.stl, bogie_plate.dxf, bogie_plate.step, diff_bar.dxf, diff_bar.step, diff_post.step, orchard_robot_full.f3d, orchard_robot_full.step]
2026-10-31 Bogie shaft: PSCS12-10 collar retains the bogie group outboard
    The SFJ12 bogie shaft is pressed into the rocker plate, but nothing held the
    bogie holder/bearings on its outer end (only a 10 mm "retaining ring"
    allowance). Add an inner-ring spacer (Ø16, l + 1) from the outer 6001 to
    1 mm past the holder flange and a MISUMI PSCS12-10 slit collar (OD 30,
    width 10, checked on misumi-ec.com). Shaft 50 -> 53; its end stays 3 mm
    inside the middle wheel. make_shaft_collar takes bore/od/width.
    Test chain extended to rocker_plate | spacer | 6001 x2 | spacer | collar,
    with holder-collar clearance and wheel clearance. Interference unchanged
    (Fusion 10 pairs, 10518.3 mm3). BOM ~1,116,000 KRW.
    Co-Autho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
    [base_link.stl, orchard_robot_full.f3d, orchard_robot_full.step, orchard_rover.urdf, rocker_bogie_assembly.f3d, rocker_bogie_assembly.step, rocker_bogie_assembly.stl]
2026-10-31 Diff pin: STWN12 snap ring retains the diff bar on its pivot pin
    The diff bar holder sat on the post pin with only a 4 mm "retaining ring
    allowance" above it, so nothing kept the bar from lifting off. Add an
    inner-ring spacer (Ø16, l + 1) from the upper 6001 to 1 mm above the holder
    and a MISUMI STWN12 shaft C-ring (t 1) in a Ø11.5 x 1.15 groove cut in the
    pin. The pin top stays 4 mm above the holder.
    A PSCS12-10 collar was tried first, but the 9 mm longer pin hit the J4
    housing with the arm folded rearward (J1 ±180, J2 0, J3 -120), raising
    combined collisions 27 -> 29. With the snap ring they stay at 27.
    Test chain extended to post | spacer | 6001 x2 | spacer | ring | post, plus
    ring-h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
    [base_link.stl, diff_post.step, orchard_robot_full.f3d, orchard_robot_full.step, orchard_rover.urdf, rocker_bogie_assembly.f3d, rocker_bogie_assembly.step, rocker_bogie_assembly.stl]
